busranurkocak/EE464-Term-Project/Presentation/Isolated_presentation.pptx

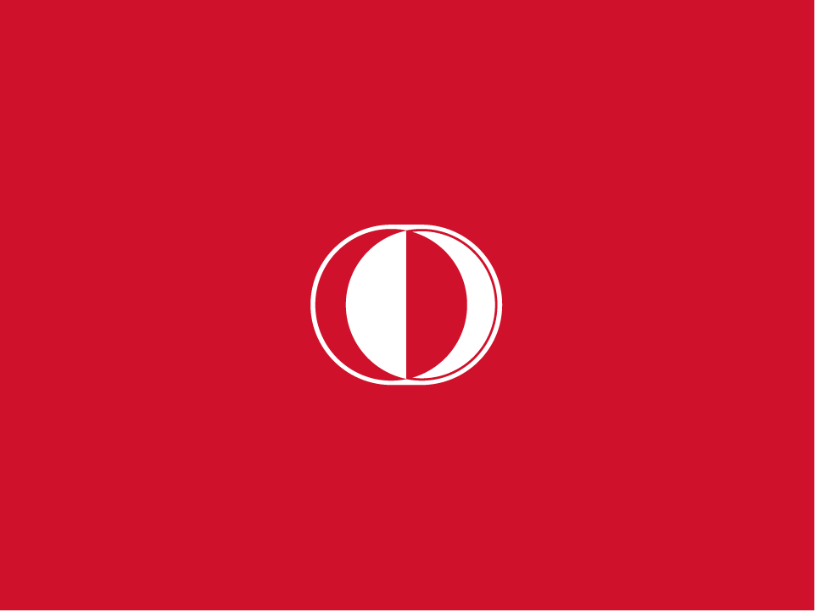
[picture p42: figure]

## Slide 2

EE464- TERM PROJECT

Büşra Nur Koçak
Defne Nur Korkmaz
Mustafa Mert Sarıkaya

May 9, 2021

## Slide 3

Topology selection
Component selection
Simulation results
PCB design
Magnetic design

## TOPOLOGY SELECTION

- FLYBACK CONVERTER


- Better utilization of transformer
- Easier to control
- DCM operation

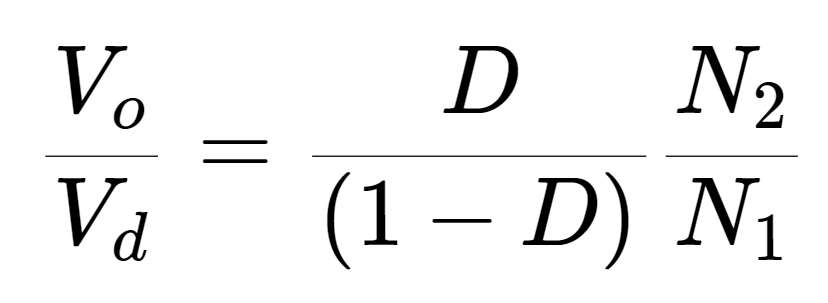
[picture p43: figure]

## Operating Values

- DCM operation:
- Limits flux density
  - Smaller core
- Reduce switching losses
- Smooth start

- D_(max) =0.2
- D_(dweel) =0.1
- f_s ≅100 kHz
- AWG #26 (skin effect)

## Magnetic Design

- K_g Method

- L_(pri) (80µH)
- Energy handling capability (1.2 mJ)
- K_g , core geometry (0.0148)
- Select core (EE-21)
- Current density
- Window area

- # of strands
- # of turns
- Air gap (0.0079 cm)
- Fringing flux
- New # of turns
- B_(pk) (0.39 T)

## Magnetic Design

- K_g Method cont’

- Winding resistance ( R_p =7.3mΩ, R_s =0.137mΩ )
- Copper loss (0.0360 W)
- K_u , window utilization
- Regulation

- Flux density
- Core loss (5.38 W)
- Temperature rise (61 ºC)

## Slide 8


## Slide 9

Turns ratio | L_(pri) | S_p (primary strands) | S_s (secondary strands) | K_u (window utilization)
6 | 80µH | 9 | 67 | 0.1

## Component Selection and Simulations

## Controller

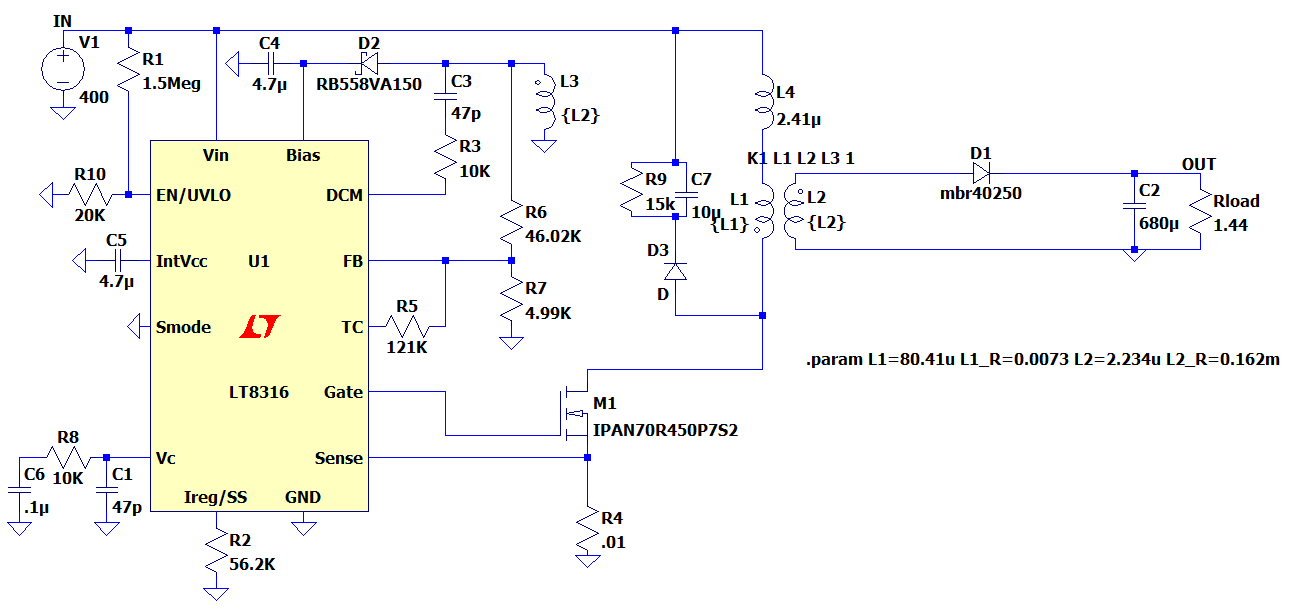
[picture p44: figure]

Parameter | Value - Description
Vin | 16V – 600V
FSW(Min) | 3 kHz
FSW(Max) | 140 kHz
Operating Junction Temperature | -40 – 125oC
Price | $2.18 (1000+ order)

## Mosfet (IPAN70R450P7S)

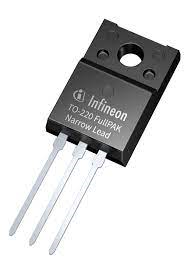
[picture p45: figure]

Parameter | Value - Description
VDS , Breakdown voltage | 700V
ID, Continuous current | 10A at TC =20 oC
ID,pulse Pulsed Drain current | 25.9 A
RDS,ON | 450mΩ
Qg | 13.1nC
Price | $1.05

## Mosfet Voltage Waveform

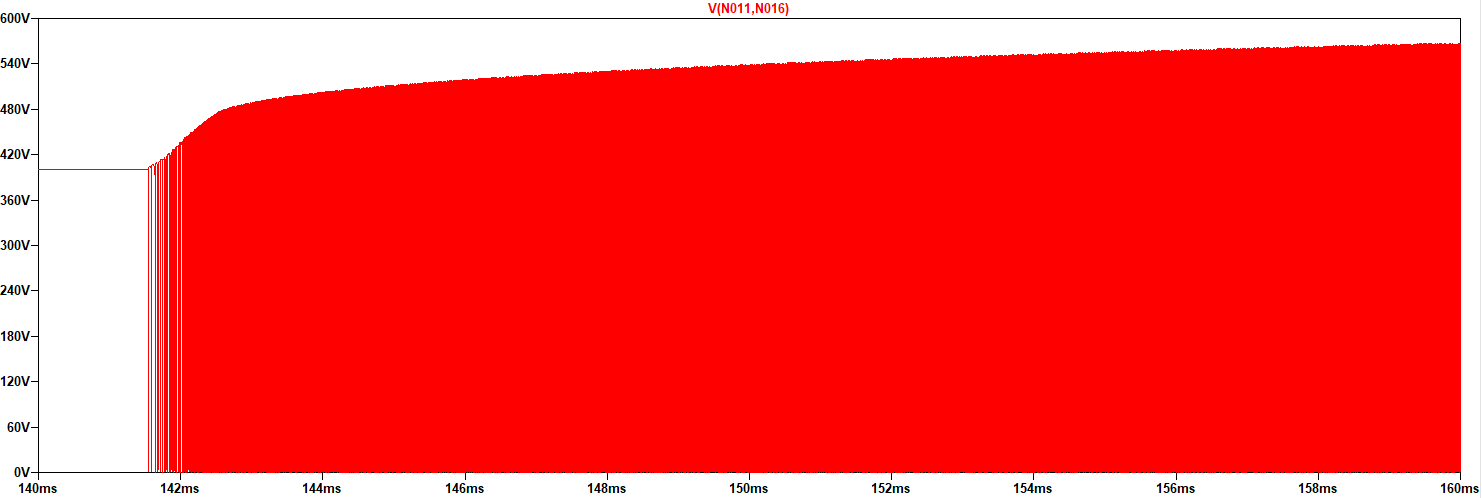
[picture p46: figure]
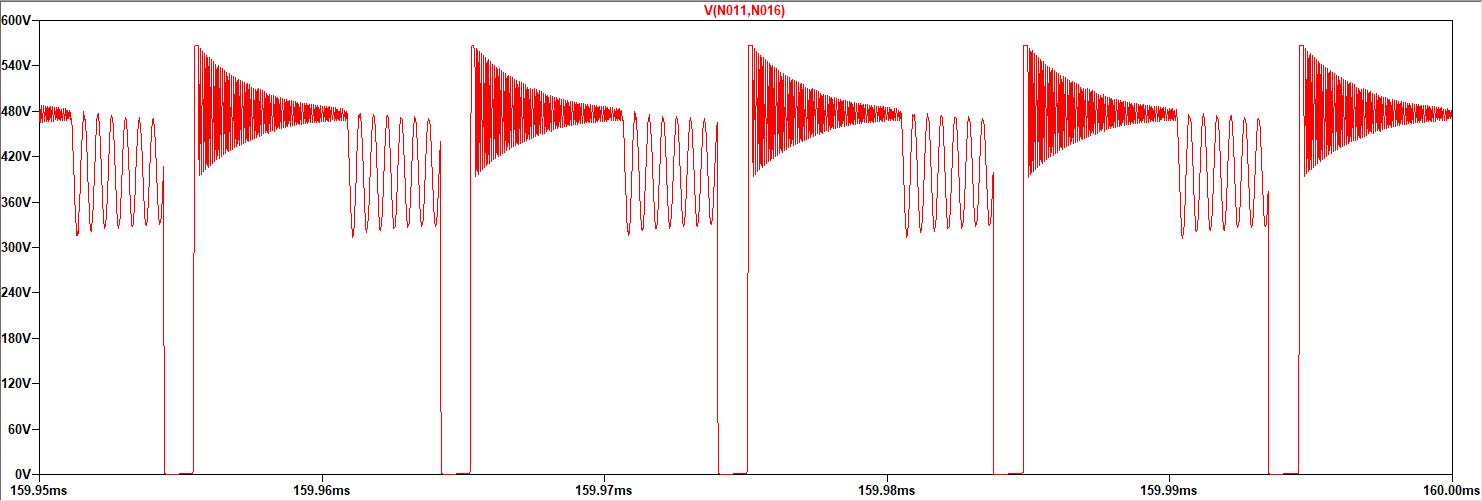
[picture p47: figure]

## Mosfet Current Waveform

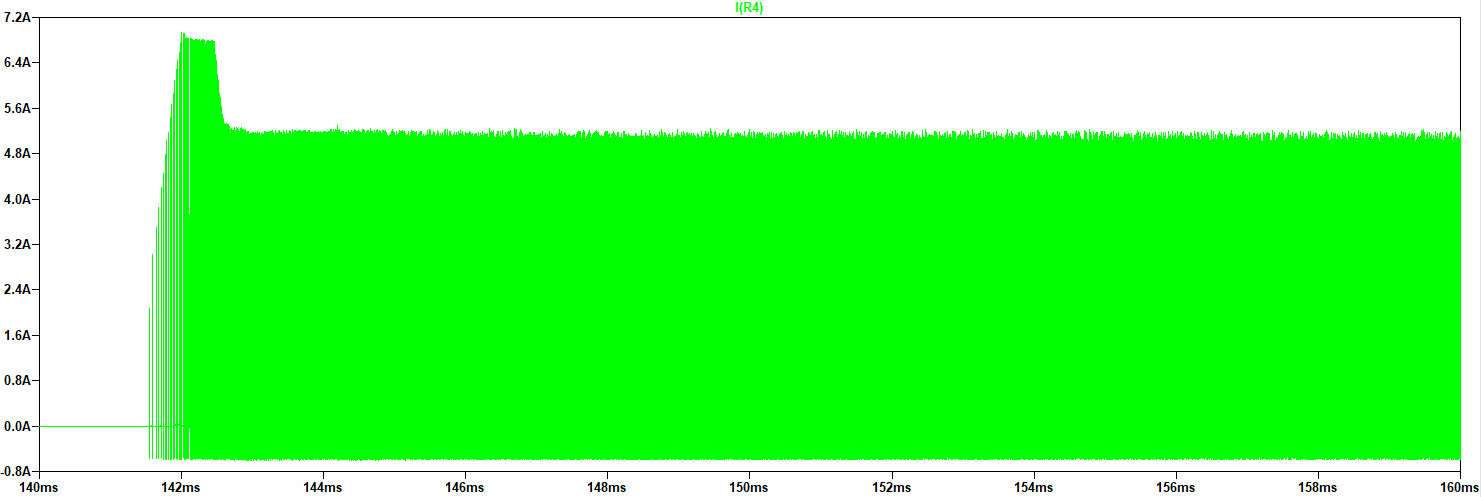
[picture p48: figure]
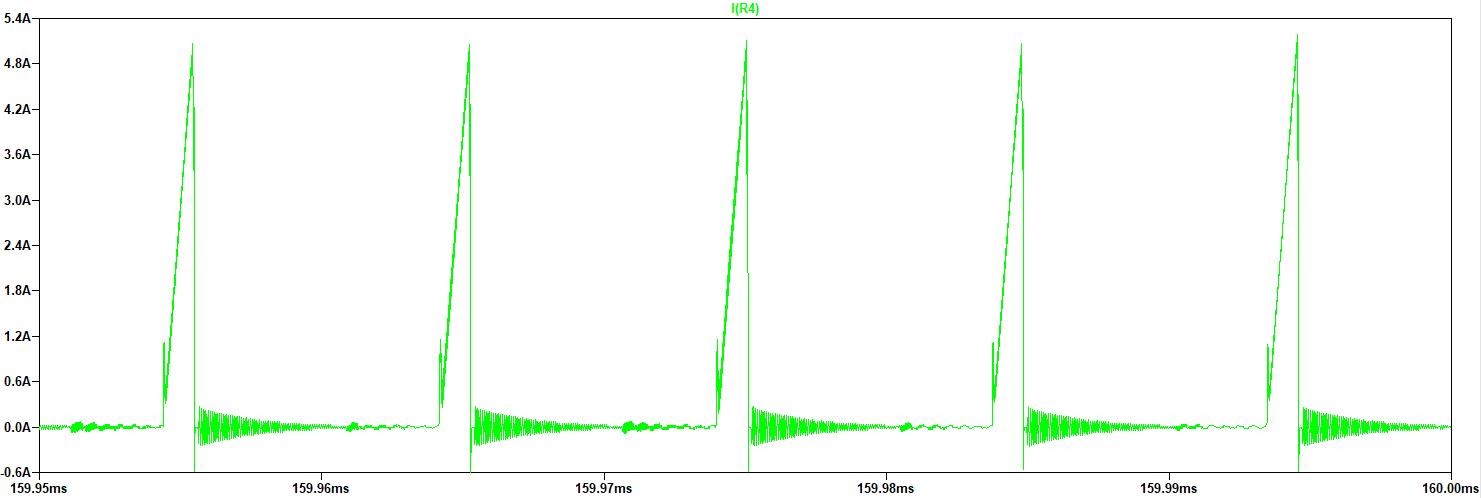
[picture p49: figure]

## Diode(MBR40250G)

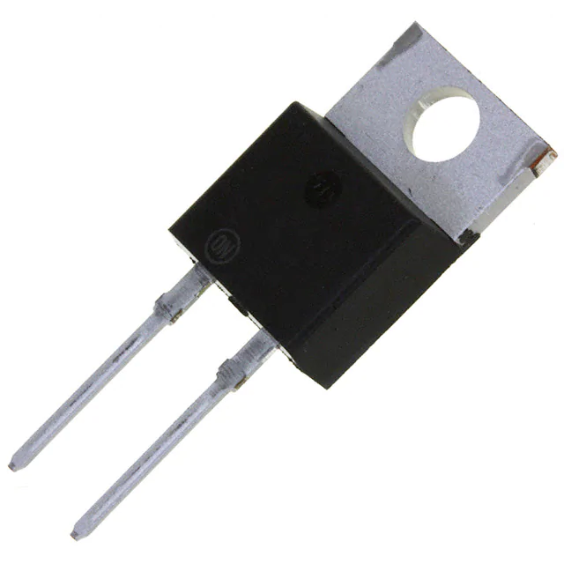
[picture p50: figure]

Parameter | Value - Description
VR , Blocking voltage | 250V
IRMS, Continuous current | 40A
IFRM, Peak Repetitive Forward Current | 80A
VF | 0.86V
Price | $1.82000

## Diode Voltage Waveform

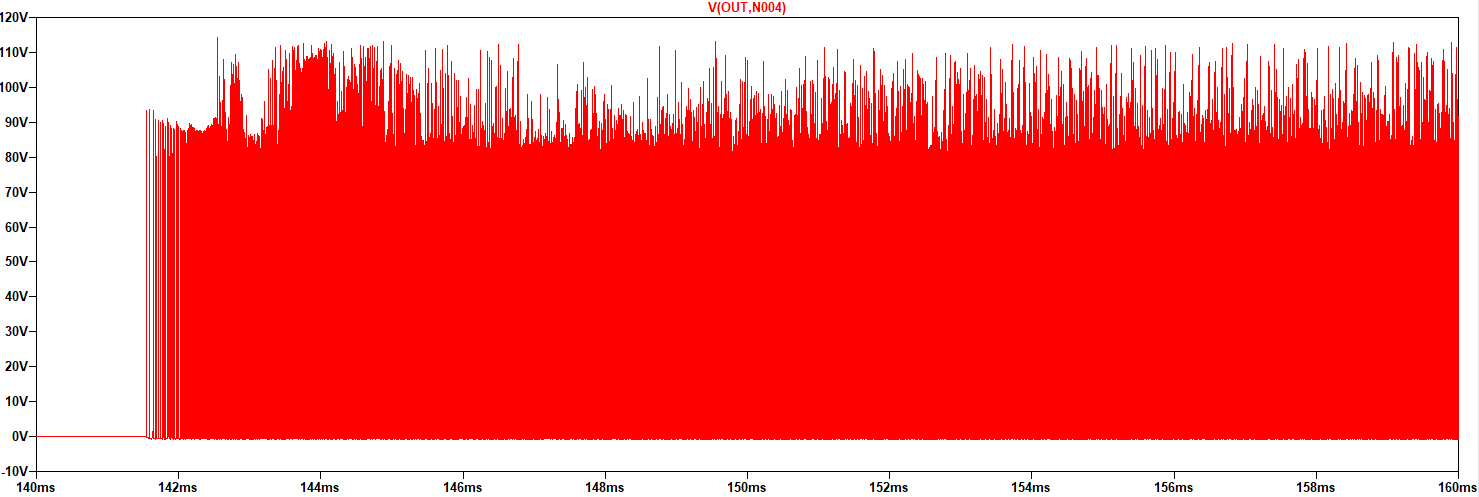
[picture p51: figure]
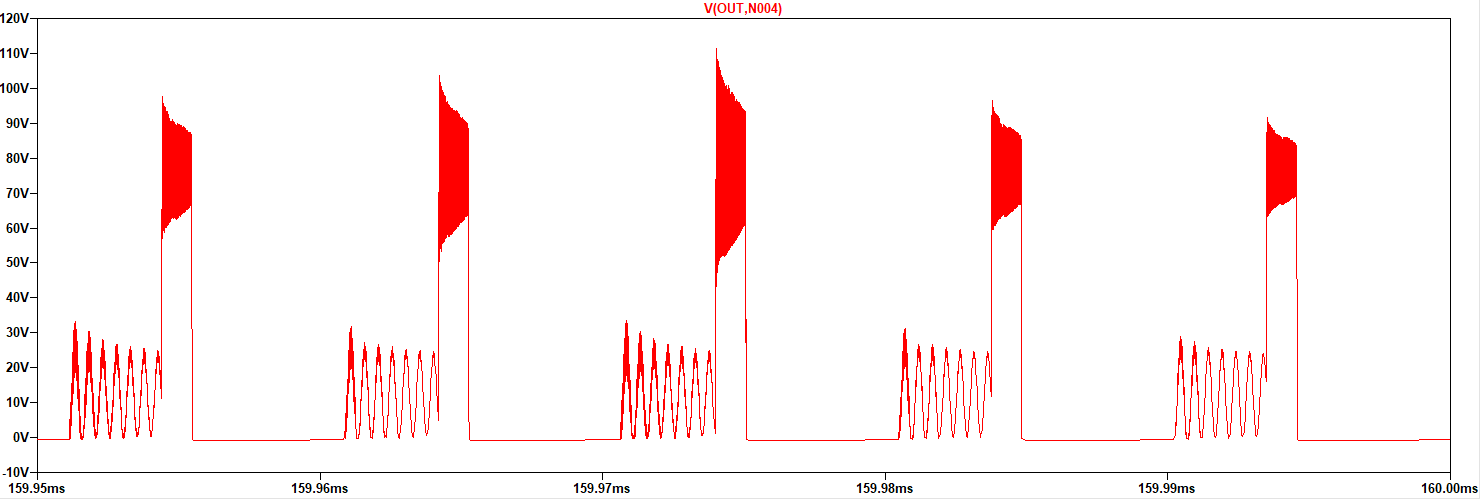
[picture p52: figure]

## Diode Current Waveform

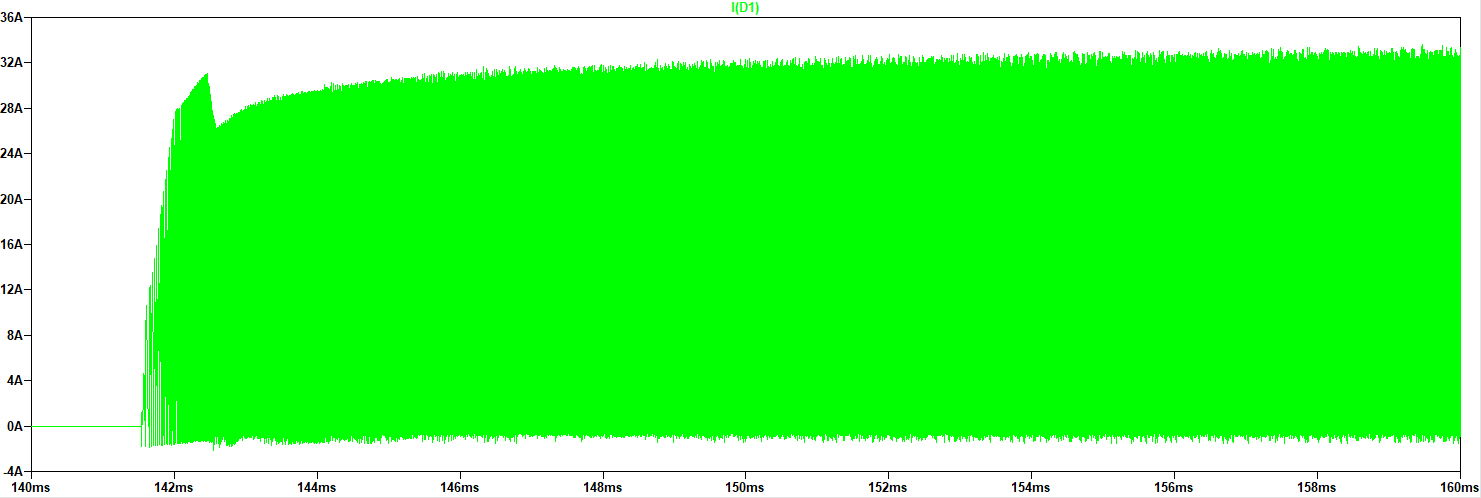
[picture p53: figure]
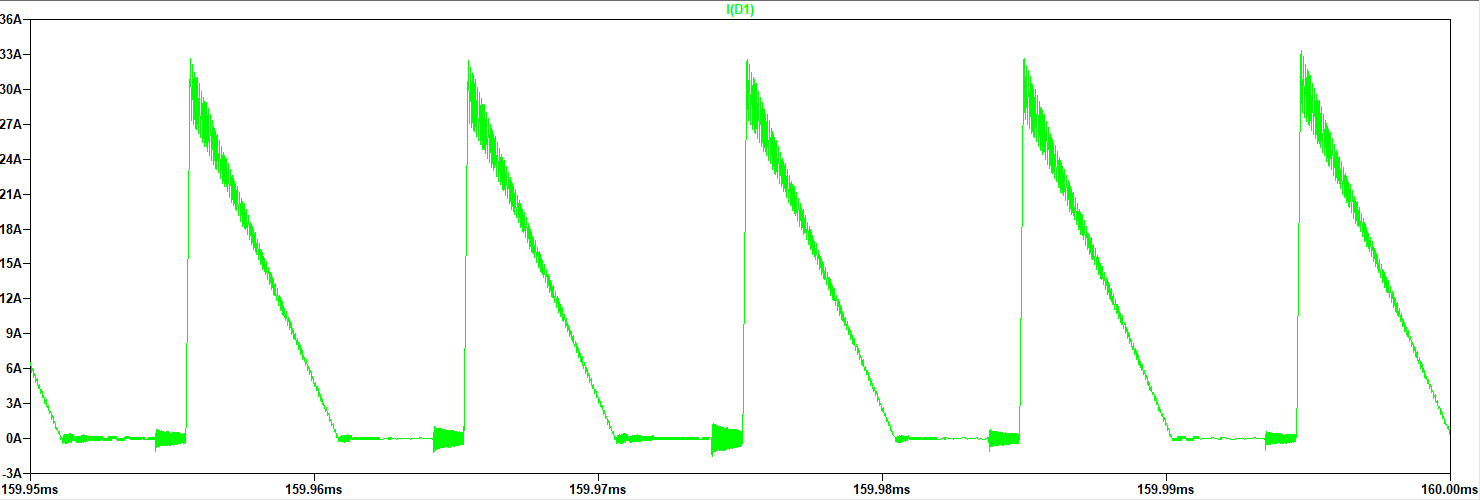
[picture p54: figure]

## Output Capacitor(RNL1C681MDS1)

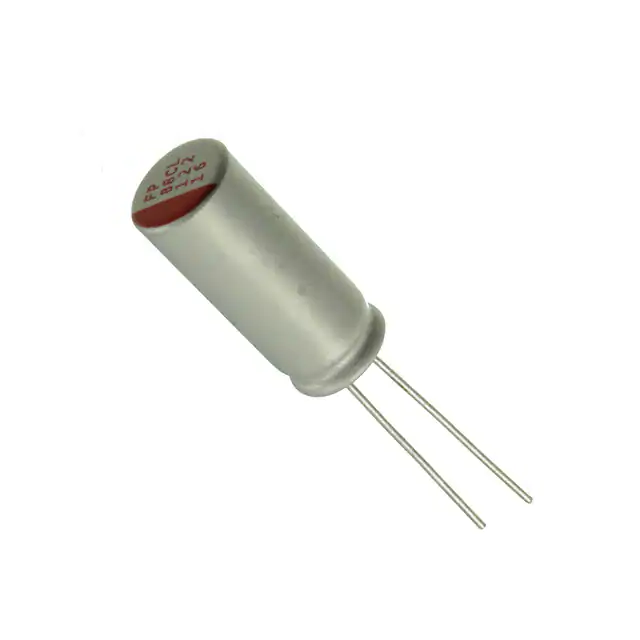
[picture p55: figure]

Parameter | Value - Description
C, Capacitance | 680 uF
VC,MAX Rating | 25V
IC,ripple | 7A
ESR | 8mΩ
Price | 1.50$

## Output Voltage Waveform

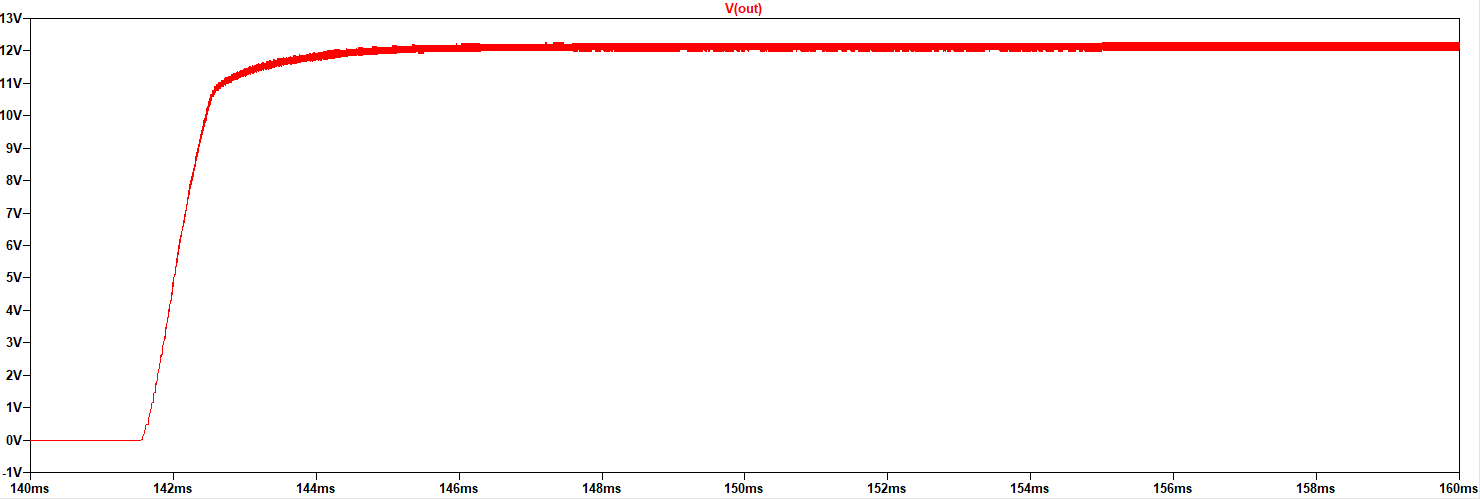
[picture p56: figure]
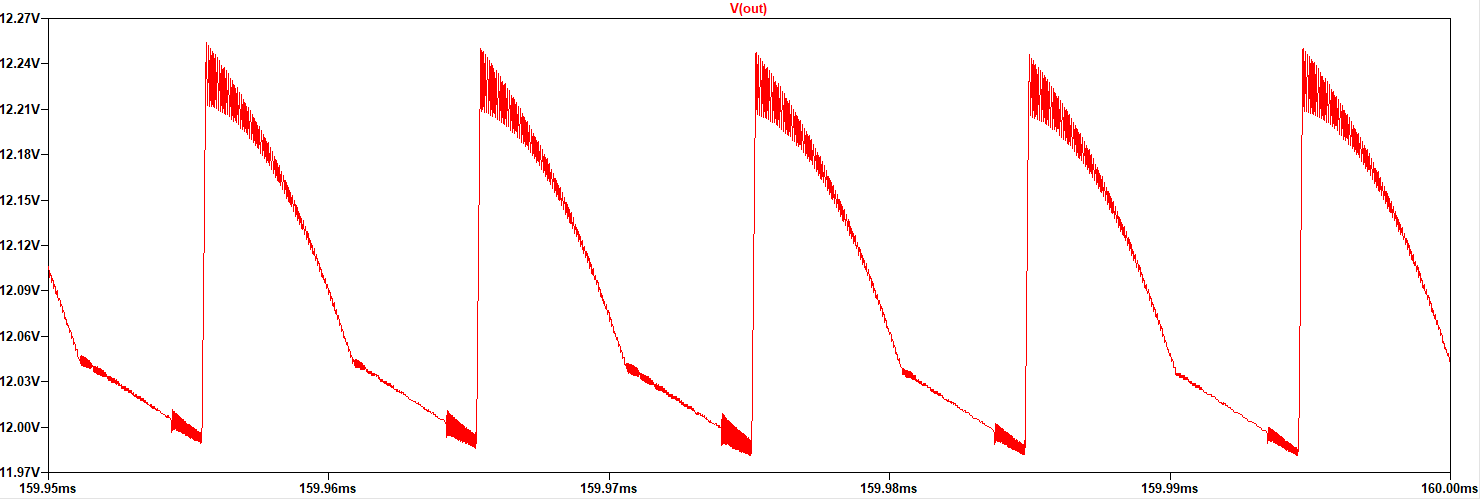
[picture p57: figure]

## Output Current Waveform

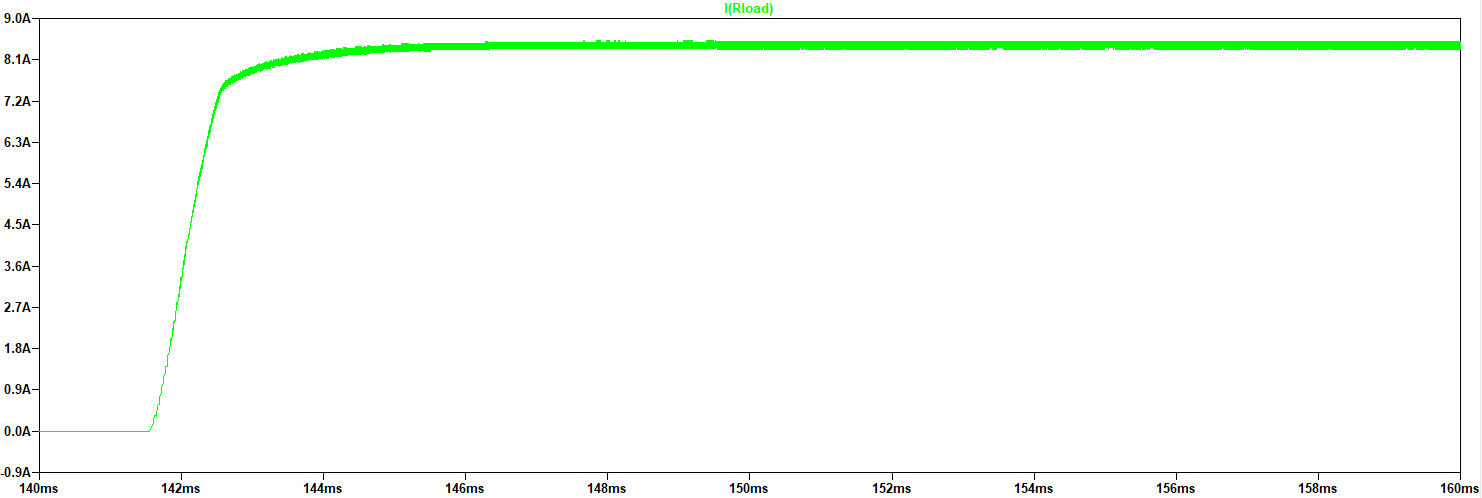
[picture p58: figure]
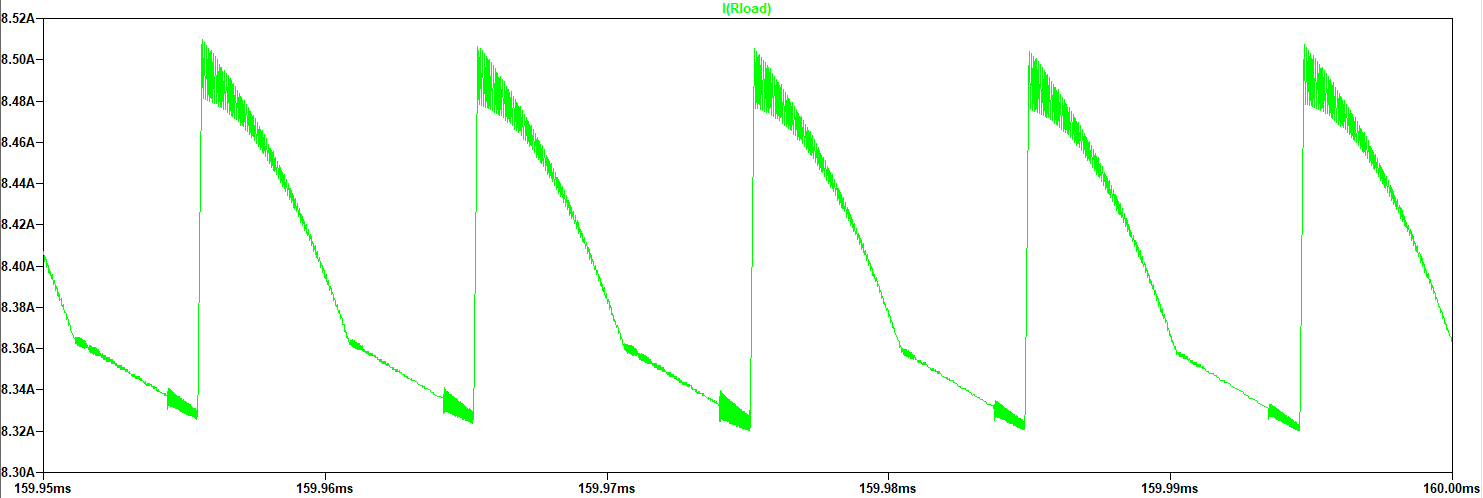
[picture p59: figure]

## Primary Inductor Current Waveform

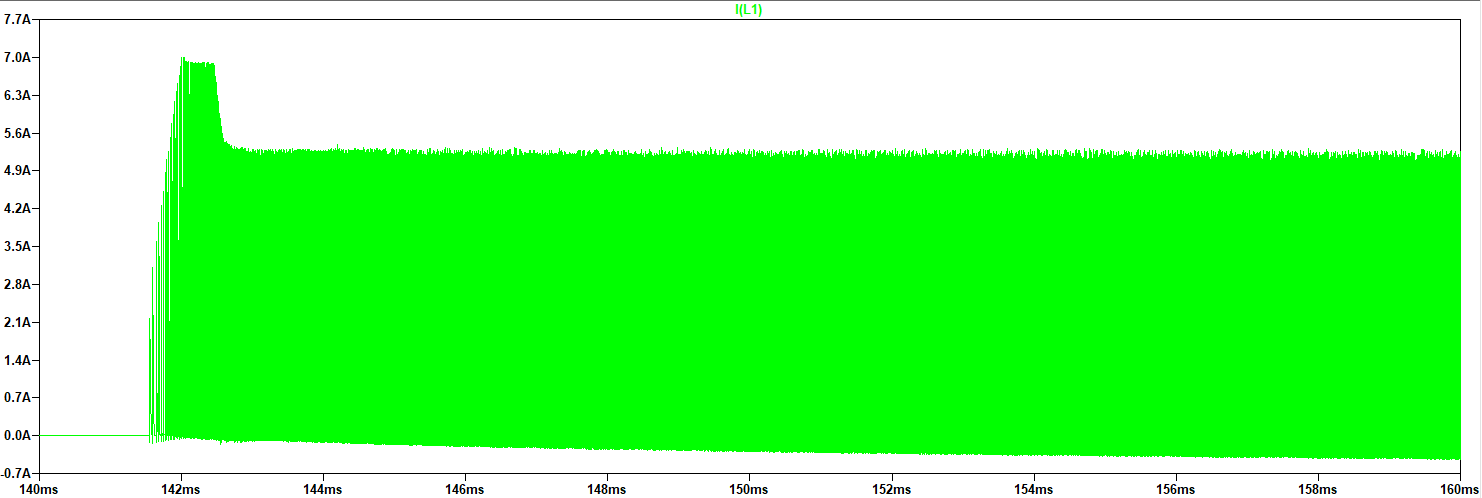
[picture p60: figure]
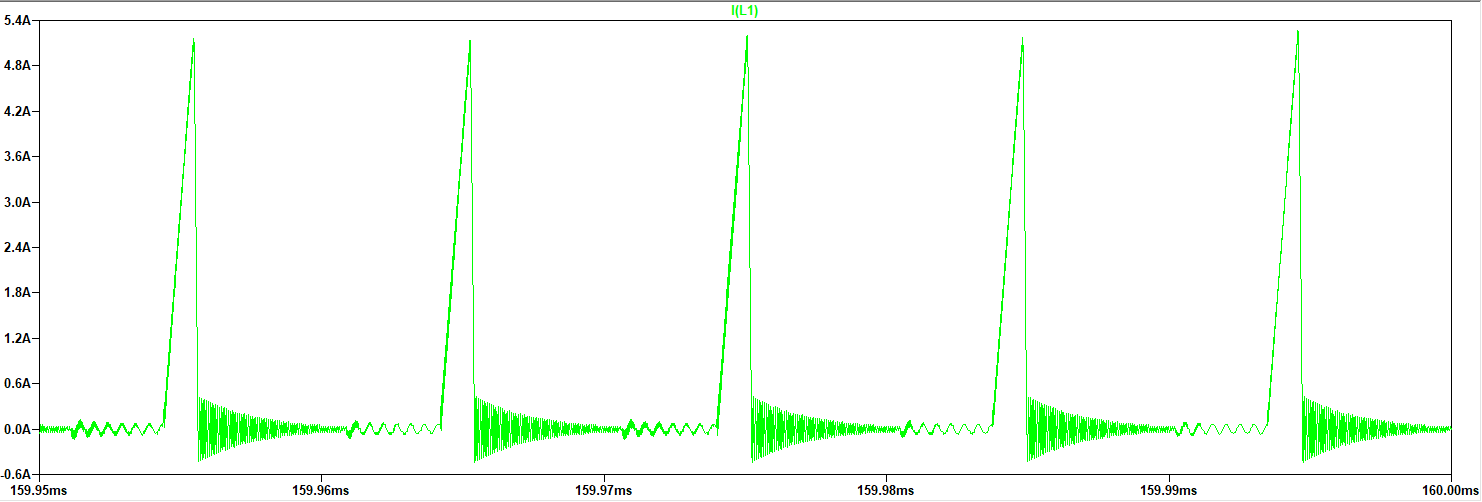
[picture p61: figure]

## Slide 22

## Slide 23
