busranurkocak/EE464-Term-Project/Simulation Report.pdf

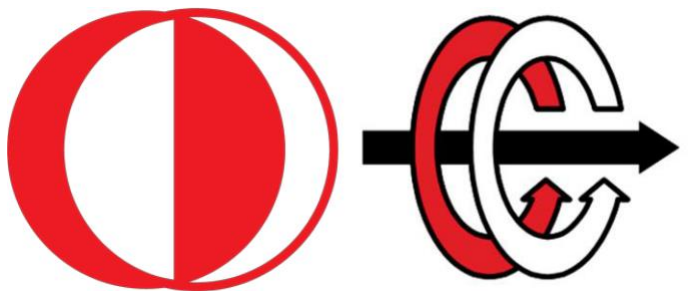
[picture p62: figure]

EE464

# STATIC POWER CONVERSION-II

## Term Project Simulation Report

## Group Isolated

Contributors
Büşra Nur KOÇAK | 1929355
Defne Nur KORKMAZ | 2166858
Mustafa Mert Sarıkaya | 2094381

## Table of Contents

## Introduction

The aim of this project is to provide the transformation that will convert the high voltage power supply output suitable for the low voltage range devices. Therefore, the study is about to reduce the input voltage ranging from 220V to 400V for the Tesla Model S’s equipment that needs 12V input voltage. Since one of the most important requirements of the project was to provide an isolated system design, the topology types used in the given operating ranges, which will allow isolated converter design, were examined. Afterwards, the controller was selected according to the selected topology and the frequency range, duty cycle and turns ratio values to be operated were determined. With the completion of the transformer design and component selections in accordance with the simulation results taken from the selected controller, the theoretical calculations and the power loss calculations of the system have been completed.

## Project Description

In this project, we are asked to design an isolated DC/DC converter in order to convert 220-400VDC input voltage to 12VDC with 100W output power. The specifications and requirement for the projects are following:

- Minimum Input Voltage: 220 V
- Maximum Input Voltage: 400 V
- Output Voltage: 12 V
- Output Power: 100 W
- Output Voltage Peak-to-Peak Ripple: 4%
- Line Regulation: 3%
- Load Regulation: 3%

## Topology Selection

### Forward Converter

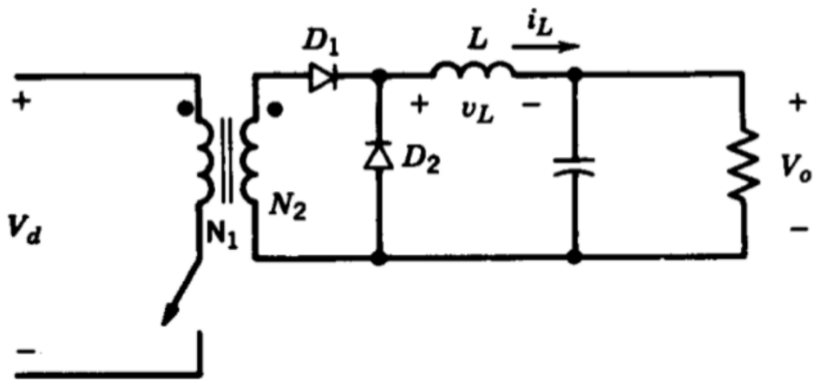
[picture p63: figure]

Figure 1: Forward Converter Topology

Advantages:

- Allows smaller transformer design than a flyback converter
- Better at isolated high-power applications
- Switching device has less voltage stress across it
- Low power losses and noise
- Does not require any snubber circuit

Disadvantages:

- The transformer core must be freed from unintentionally stored energy with each cycle
- Requires additional inductor at the output side
- More expensive
- Harder to control

### Flyback Converter


Figure 2: Flyback Converter Topology

Advantages:

- Better utilization of transformer
- Output inductor and diode ensure continuous output current
- More efficient to filter out high-frequency components
- Easier to control
- DCM operation allows soft switching
- Allows to use smaller transformer core
- Reduce switching losses

Disadvantages:

- Higher voltage stress across the MOSFET
- Gain changes a lot in DCM operation

Forward and Flyback converter topologies have been considered and examined in detailed while deciding on the topology which will be used in the project. According to the advantages and disadvantages of the both topologies, it has been decided to work on the Flyback converter design. While making the topology selection, some of the important factors have been evaluated as providing easier control of the converter and finding isolated controller options that meets the project requirements. In addition to these, the difficulty of controlling the forward converter and the possibility of causing problems in cases where the energy on the transformer could not be discharged regularly, made it certain to prefer the flyback converter topology.

## Analytical Calculations

### Transformer Calculations

In an isolated flyback converter design, the core selection completely depends on the operating frequencies. As the operating frequency increases, maximum flux density created will decrease; therefore, increasing operating frequency is an advantage to prevent saturation in the core and also helps to use smaller core structure with increased efficiency. Smaller transformer core also helps to decrease the cost and size of the converter with a considerable amount. Therefore, the calculations of the transformer have been conducted considering 100kHz operating frequency, even though it will be adjusted by the flyback controller itself.

Moreover, operating region is also an important factor while deciding the size of the transformer core, where DCM operation allows to design smaller transformers by limiting flux density in the core and prevents from the saturation problems. Therefore, DCM operation has been assumed to be used in the design while calculating transformer values and dwell time duty ratio (Dw) is assumed to be 0.1.

In the first transformer design of the process, ferrite cores with an additional gap will be considered using Kg method, which allows to calculate required air gap, fringing losses and the cable losses in the transformer design. Moreover, this method allows to count the required strands number for the Litz wire design according to the selected core properties.

### Skin Effect

Operating frequency of the transformer is a primary property while deciding the cable size, which will be used during the design. Increasing operating frequency will cause current to flow from more outer part of the cable. Therefore, the middle part of the cable will be useless in the conduction period and this will cause increase in the resistance values. Considering this relationship between the frequency and cable size, it is preferred to design the transformer cables as Litz wire with multiple strands by calculating the number of layers which should be used for primary and secondary sides. Considering this perspective, calculating the skin depth for 100kHz gave an important clue while deciding the size of the cable which will be layered.

ε =

6.62
√f

=

6.62
√100 × 10³

= 0.0209 → Wire Diameter = 2ε

= 0.0418

[1]

According to the calculation done in the [1], it had been decided to use #26 AWG wire as base wire while designing the Litz wire size and number of layer requirements.

### Ferrite Core Calculations

The first specification which should be considered while designing the transformer for flyback converter is that the energy storage capability of the core. Therefore, the inductance needed for the storage of a specific amount of energy storage is also important.

Rin(eqiv) =

(Vin(min))

2

Pin(max)

→ L =

Rin(equiv)TDmax

2
2

→ Energy

=

LIp(pk)

2
2

[2]

As the name suggest Kg value, which is a core geometry values includes both energy requirements of the transformer application. Therefore, this value has been calculated first to decide the limiting value for the power handling capacities of the core selection.

Ke = 0.145PoBm

2 × 10⁻⁴ → Kg =

(Energy)

2
Ke ∝

[cm⁵
]

[3]

Considering both the Kg value, saturation conditions of the ferrite cores, window area, permeability and inductance value per N

2
, EE-21 core have been chosen to be the core of the transformer design to continue with the calculations.

Table 1. Design data for EE ferrite cores

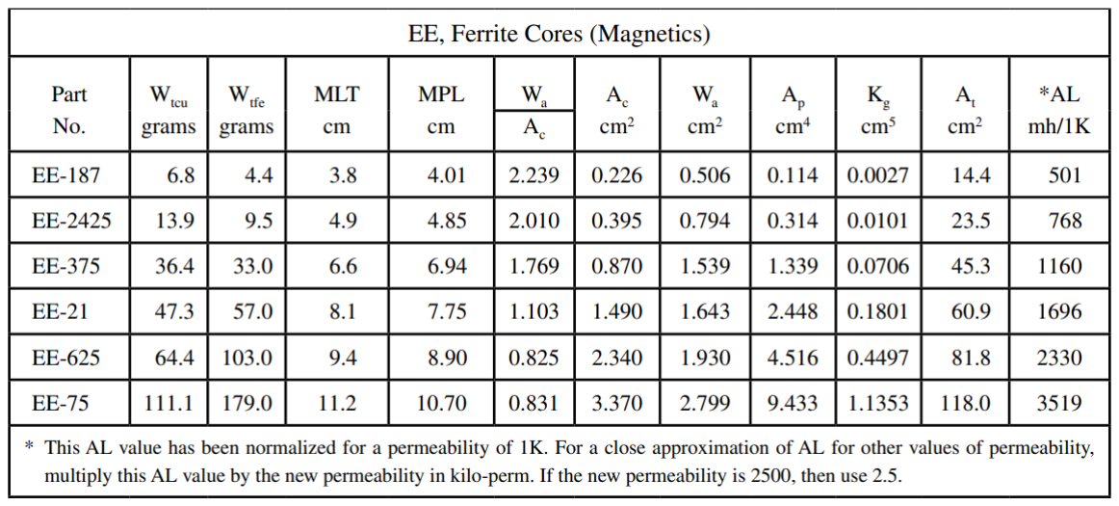
[picture p64: figure]

Before getting into the core calculations, the peak and rms values of the primary current have been calculated for the future calculations considering both current density in the core and strands numbers required for the transformer design.

Ip(pk) =

2Po(max)T

ηVin(min)

ton(max)

[amps peak], Ip(rms)

= Ip(pk)√
ton
3T

[amps]

[4]

Moreover, the values of the selected core structure have been used to calculate the current density, wire area in the core, required number of strands and number of turns with the Equations [5], [6], [7], [8].

J =

2(Energy) × 10⁴
BmApKu

[A/cm²
]

[5]

Bm: Maximum flux density, [T]

Ap: Area Product, [cm⁴
]

Ku: Window utilization, 0.29

Apw =

Ip(rms)
J

[6]

Apw: Primary wire area

Snp =

Awp
#26(bare area)

[7]

Snp: Required number of primary strands

Np =

Ku Wa⁄2
3(#26(bare area))

[turns]

[8]

Wa: Window area of the core

Np: Number of primary turns

Because of the high permeability values of the ferrite cores, storing the required energy in the core requires some additional gap. Calculation of the additional gap for storing previously specified energy value can be observed from Equation [9].

lg =

0.4πN

2Ac × 10⁻⁸
L

−

MPL
μ

[cm]

[9]

Ac
: Iron area

MPL: Magnetic path length

μ: Permeability of the core material

It should be also considered that even though adding a gap to increase the energy storage capability of the ferrite core is a preferred method at some cases, it has some disadvantages as fringing flux. Therefore, this effect should be also calculated to consider its effect on the power loss of the transformer design.

F = 1 +

lg
√Ac

ln (

2G
lg

)

[10]

Moreover, the fringing flux also has an effect on the number of required turns in the primary side of the transformer and the peak flux density as follows.

Nnp = √
lgL
0.4πAcF10⁻⁸

[11]

Nnp: New number of turns for the primary

Bpk =

0.4πNnpFIp(pk)10⁻⁴

lg +

MPL
μ

[T]

[12]

MPL: Magnetic path length

As the number of turn and strands values of the primary have been completed, ESR resistance of this side can be also determined by considering both the designed Litz wire strands, #26 AWG copper wire resistance property, number of turns in the primary and the magnetic path length of the selected core.

Rp = MLT(Nnp) (
μΩ⁄cm

Snp ) × 10⁻⁶
[Ω]

[13]

Moreover, secondary side of the transformer can be calculated with the values, which have been calculated so far. Decided duty cycle and dwell time duty ratio plays an important role while calculating the secondary side of the transformer. Moreover, the voltage drop on the output part of the flyback converter is assumed to be 1V during the calculations.

Ns =

Nnp(Vo + Vd)(1 − Dmax − Dw)

VpDmax

[14]

Other than the turn number of the secondary of the transformer, same calculations have been applied to calculate secondary peak current, rms current, wire area, secondary strands number, and winding resistance.

Turns ratio | Lm(mutual inductance) | Sp(primary strands) | Ss (secondary strands) | Ku(window utilization)
6 | 80µH | 9 | 67 | 0.1

### Component Power Calculations

Specifications of project are

Vin(min) =220 V,

Vin(max) =400V,

Pout =100W,

Vout=12V

We have to decide some values for calculation and to get smaller transformer and ripples we decide switch frequency as 100khz. Our system will operate in Discontinuous conduction mode and we decide dwell time as one over ten period time. Also, maximum duty ratio as taken 0.2. Our secondary side diode will operate at high current so we can’t just assume its on voltage as zero volt, before deciding diode we take diode on voltage as 1V. Transformer won’t operate at 100% efficiency and before designing that we assume efficiency as 90%. So decided values are as given.

fS = 100kHz

Ddwell = 0.1

Dmax= 0.2 at 220V and Dmin = 0.11 at 400V

Vdiode = 1 V

ɳtransformer = 0.9

Primary and Secondary powers

By using output power and output voltage, average output current calculated. Then diodes power dissipation added and secondary sides total power calculated. Transformer is not ideal and we choose efficiency as 90% percent and primary sides power calculated with including core loss.

Iout(avg)= Pout / Vout = 8.33 A

Pdiode = Vdiode x Iout(avg) = 8.33 W

Psecondary = Pdiode + Pout = 108.33 W

Pprimary = Psecondary / ɳtransformer = 120.37 W

Primary and secondary sides peak current:

Primary and secondary sides inductor current is triangular shape and its peak value calculated with the following equations.

For 220 volt source voltage:

Iin(avg) = Pprimary / Vin(min) = 0.55 A

Iin(peak) = 2 x ( Iin(avg) / Dmax) = 5.47 A

For 400 volt source voltage:

Iin(avg) = Pprimary / Vin(max) = 0.55 A = 0.30 A

Iin(peak) = 2 x ( Iin(avg) / Dmin) = 5.47 A

Isecondary(peak) = 2 x (Iout(avg) / (1 - Dmax - Ddwell)) = 23. 80 A

Ratings of Components

Transformer, Mosfet, Diode and Output Capacitor are important components for flyback converter, Transformer’s calculation showed in previous part and turn ratio taken as 6. Mosfet, Diode and Output Capacitors required ratings analytically calculated in following equations.

Nturn = 6

For Mosfet:

VDS(max) = Vin(max) + (Vout x Nturn) = 472 V

IDS(peak) = Iin(peak) = 5.47 A

For Diode:

VD(max) = Vout(max) + (Vin(max) / Nturn) = 78.67 V

ID(max) = Isecondary(peak) = 23.80 A

Output Capacitor:

∆Vout(max) = Vout x (3/100) = 0.36 V

IC(pp) =(Iout(avg) x (1+ ((Dmax + Ddwell) / (1 - Dmax - Ddwell))) = 11.90 A

∆VESR = ESR x IC(pp) = ESR x 11.90

∆QC = Iout(avg) x (Dmax + Ddwell) / (Cout x fS) = 2.5x10⁻⁵ C

∆VC = ∆QC / Cout = 2.5x10⁻⁵
/ Cout

∆Vout = ∆VESR + ∆VC = ESR x 11.90 + 2.5x10⁻⁵
/ Cout

When Cout is infinity ESR must be smaller than 30.25 mΩ

When ESR is zero Cout must be bigger than 69.44 uF

## Component Selection

In the previous part, we have decided the required component values with the LTSpice simulation tool and calculations. To provide a reliable design, we considered the inrush currents and surge voltages. Therefore, we have chosen our components by considering the maximum power rating and its tolerance. Also, in order to decrease the final size of the design, we tried to choose the component in small packages.

At first, we have decided on the controller. We have needed a flyback controller which provides 100W power and around 100kHz frequency range to decrease the size of the transformer. Also, to make the simulation part easier, we looked for the Analog Design Manufacturer. In the end we have decided on the LT8316 controller.

Then, we looked for the semiconductor components which are MOSFET as a switch, diodes for the secondary side of the converter and for biasing of the controller. As a mosfet, we have decided on IPAN70R450P7S. Its ratings are given in Table 2.

Table 2. Mosfet Ratings

Parameter | Value - Description
VDS , Breakdown voltage | 700V
ID, Continuous current | 10A at TC =20 oC
ID,pulse Pulsed Drain current | 25.9 A
RDS,ON | 450mΩ
Qg | 13.1nC
Price | $1.05

Then, the diode of the secondary side is chosen as MBR40250G which provides 40A continuous current and 80A repetitive current.

Table 3. Diode Ratings

Parameter | Value - Description
VR , Blocking voltage | 250V
IRMS, Continuous current | 40A
IFRM, Peak Repetitive Forward Current | 80A
VF | 0.86V
Price | $1.82000

The biasing diode is chosen as to provide 5A continuous and 8A surge current. Also, it needs a small forward voltage. For this purpose, we have decided on BAS3010A03WE6327HTSA1 diode.

Then, we have worked on the capacitors and resistors in the circuit. The most important capacitor is output capacitor and the most important resistor is sense resistor. The output capacitor is chosen as it represents low ESR value and appropriate capacitance and voltage rating. Therefore, it is chosen as RNL1C681MDS1.

Table 4. Output Capacitor Ratings

Parameter | Value - Description
C, Capacitance | 680uF
VC,MAX Rating | 25V
IC,ripple | 7A
ESR | 8mΩ
Price | 1.50$ - (QTY:1)

The sense resistor should be in small resistance value and should handle the power that will flow through it. Therefore, it is chosen as WK73S2ATTDR10J which is 100mΩ and 1W power rating resistor.

The other capacitors and resistors are chosen according to their voltage value on the simulation. The important thing is here, they are chosen the smallest package in the required ranges.

## Simulations

After components selected their model implemented in LTspice and simulations test applied under given condition.

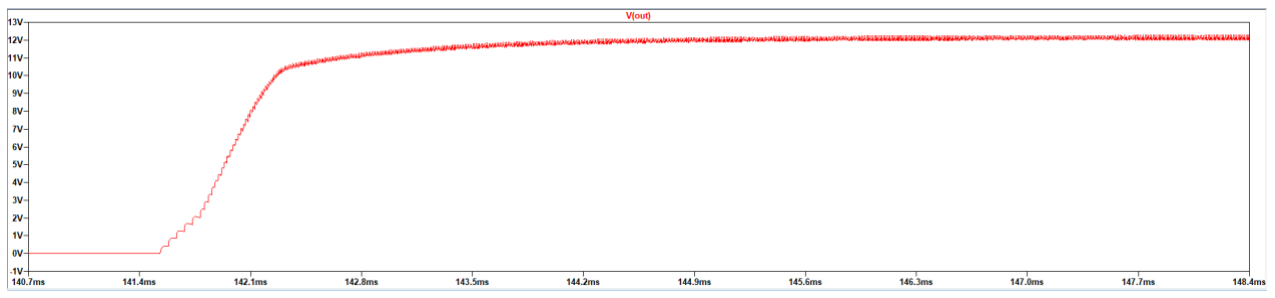
[picture p65: figure]

Figure 3: Output voltage waveform

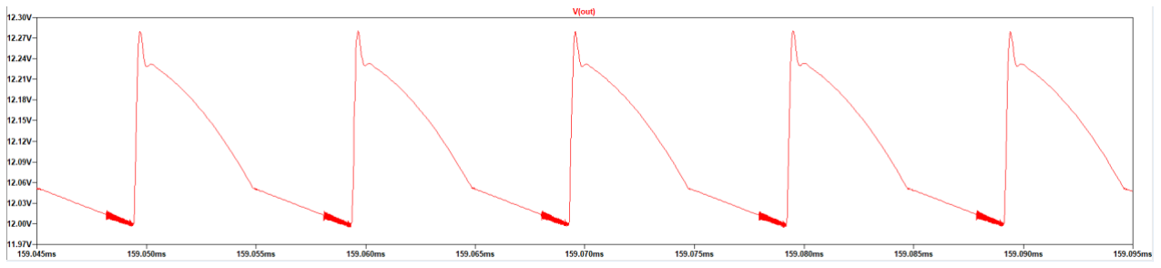
[picture p66: figure]

Figure 4: Output voltage close view waveform

As seen in the figure 3 after system turn on output voltage increase to the 12 V and give stable output voltage. Figure 4 shows ripple of output voltage and it is 0.28 V so output voltage ripple ratio is 2.33% and it is appropriate for project requirements.

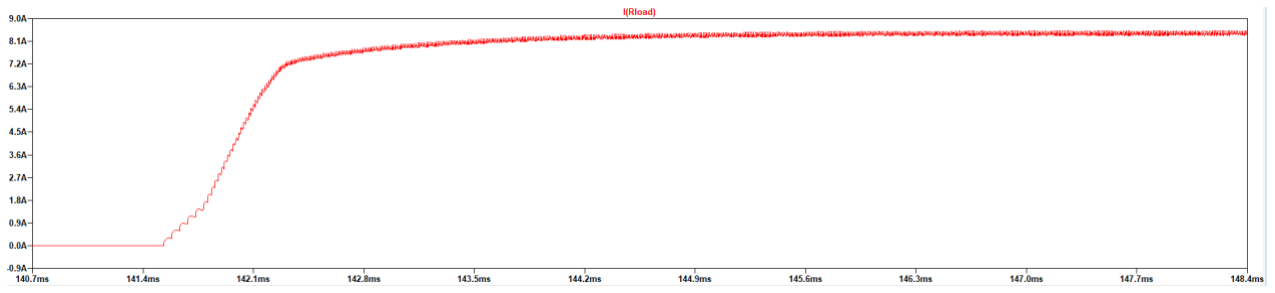
[picture p67: figure]

Figure 5: Output current waveform

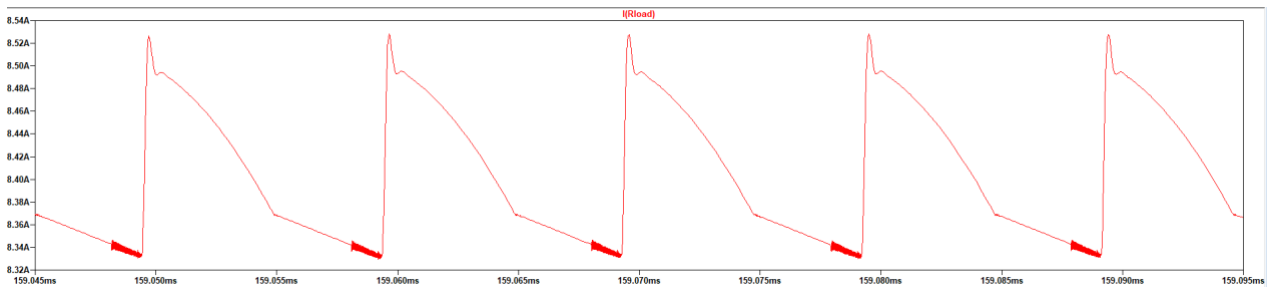
[picture p68: figure]

Figure 6: Output current close view waveform

In simulation tested load taken as fully resistive component and it is 1.44Ω so output current waveforms same as voltage and output power 101.15 W and it is little exceeding our rated power.

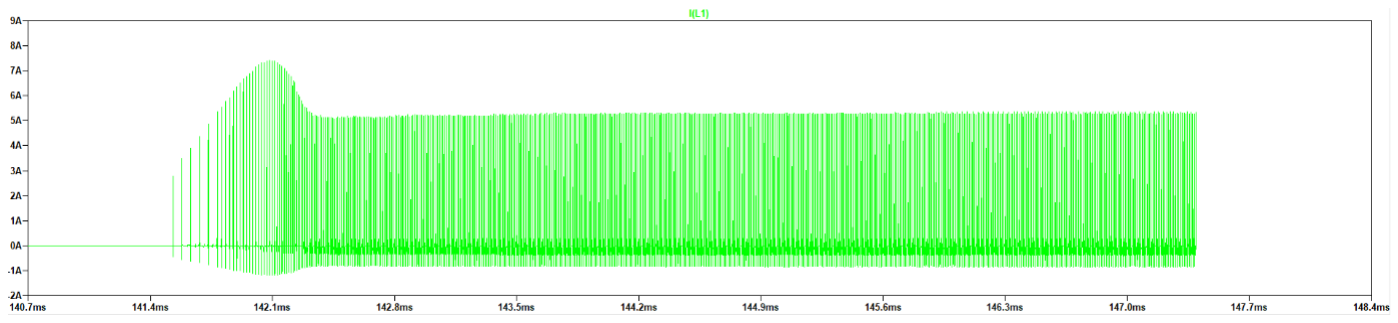
[picture p69: figure]

Figure 7: Primary inductor current waveform

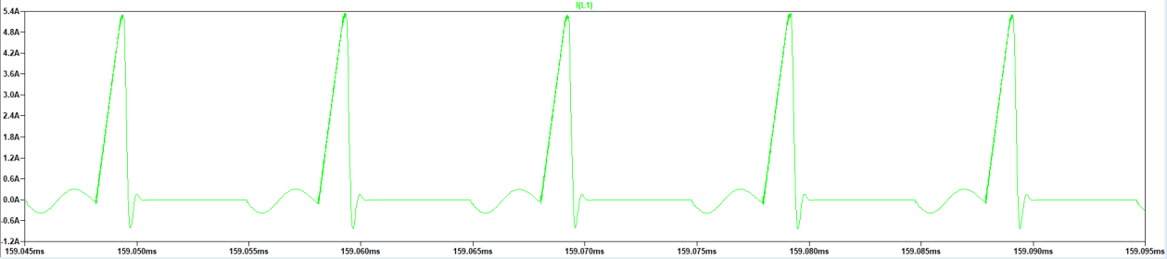
[picture p70: figure]

Figure 8: Primary inductor current close view waveform

When we look at the figure 7 its seen that initially current increase up to 7.5A then it is settled at 5.2A because initially output voltage is zero and system have to charge output capacitance and feedback system of the controller increase duty cycle and this result higher primary current. At figure 8 triangular shape of inductor current seen at mosfet on.

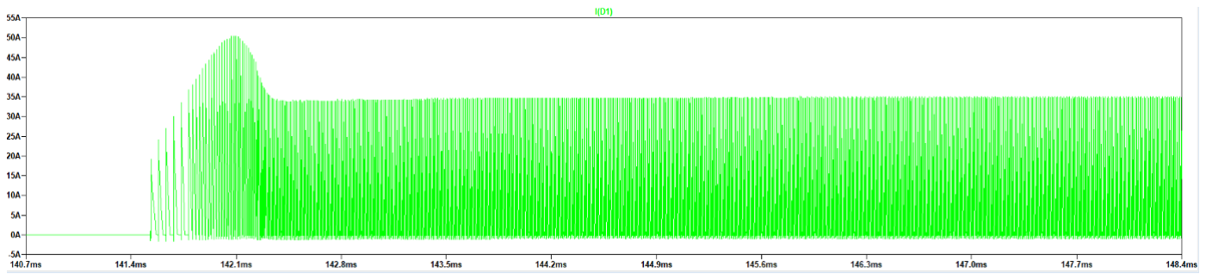
[picture p71: figure]

Figure 9: Secondary inductor current waveform

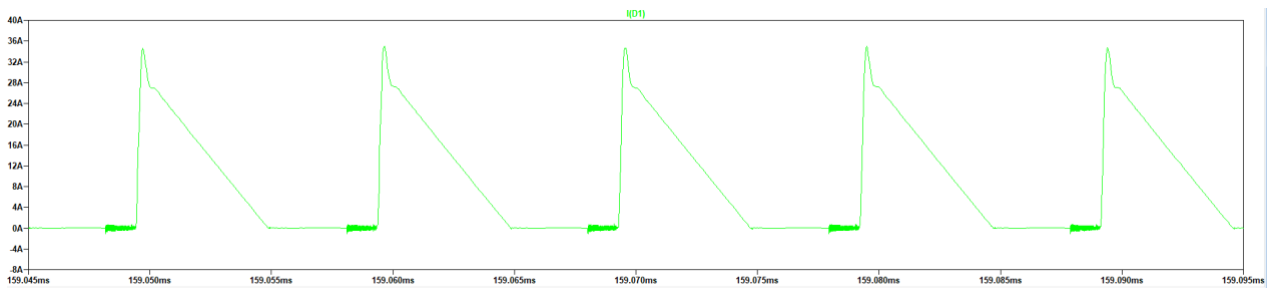
[picture p72: figure]

Figure 10: Secondary inductor current close view waveform

Secondary part of transformer has higher current density and its pulsative current reach 50 A at initial time then it is fixed at 35A.

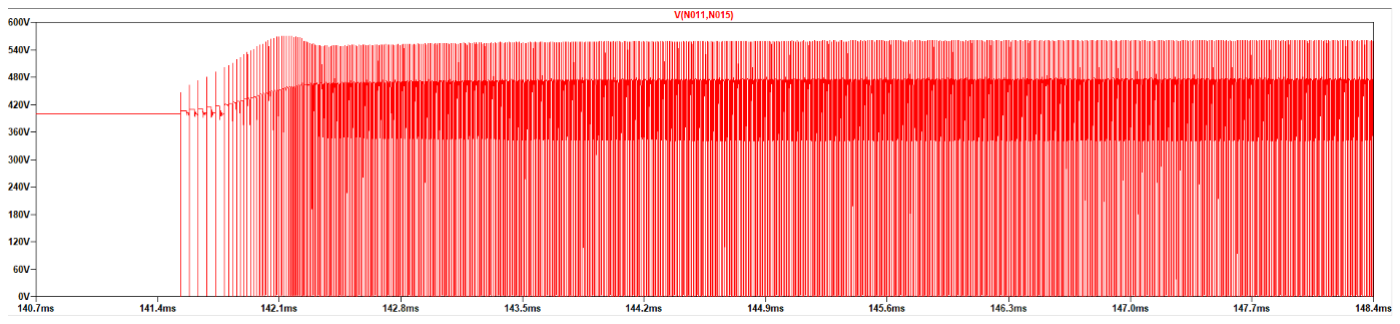
[picture p73: figure]

Figure 11: Mosfet voltage waveform

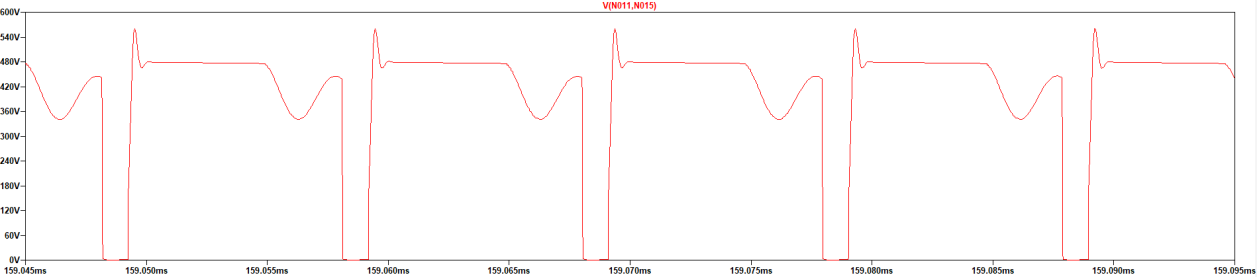
[picture p74: figure]

Figure 12: Mosfet voltage close view waveform

Selected mosfets breakdown voltage is 700 V and as seen in the figure 12 its voltage jumps to the 560V when it is turn of because of the leakage inductance then it decrease to the 478V. At Ddwell time its voltage oscillates. When looked at the figure 9 and 11 they’re in the our mosfets operation region.

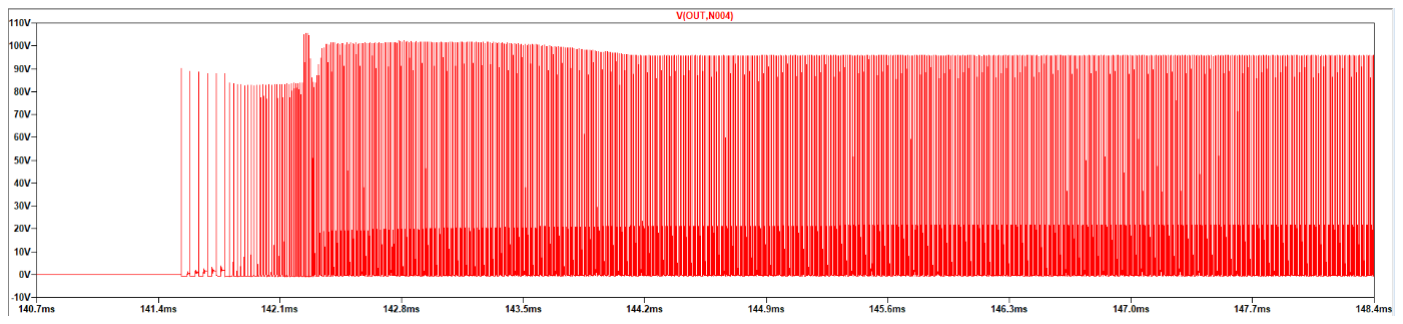
[picture p75: figure]

Figure 13: Diode voltage waveform

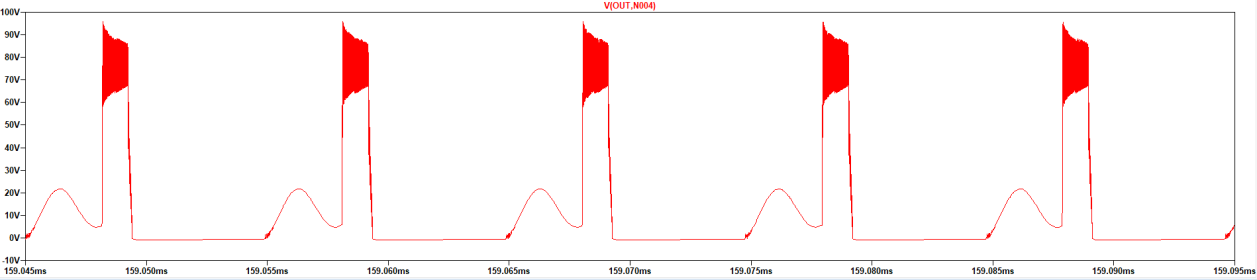
[picture p76: figure]

Figure 14: Diode voltage close view waveform

Selected diode breakdown voltage is 250 V and it can operate this voltage ratios. Diodes continuous current 40 A and as figure 9 shows secondary sides current reach 50 A initially but it is pulsative current and diode can operate pulsative current up to 80 A.

## Power Losses

### Transformer Power Losses

Required length of wire have been calculated for both primary and secondary in the transformer calculations part. Moreover, required number of strands also considered in both sides. A third winding is also necessary similar with the secondary side of the transformer for carrying reference voltage to the feedback pin of the transformer. As the primary and secondary windings’ resistances and rms currents have been calculated before, their copper losses can also be calculated.

Pcu = Ip

2Rp + Is

2Rs = 0.036 | [15]

In addition to the copper losses, there is also core losses exist due to fringing flux caused by the added gap in the ferrite core.

Bac =

0.4πNnpF (

Ip(pk)
2

) 10⁻⁴

lg +

MPL
μ

[T]

[16]

Bac: AC flux density

WK = 4.855 × 10⁻⁵
(f)

1.63(Bac)

2.62 [W/kg] | [17]

WK: Watts per kilogram

Pfe = (

mW g
) Wrfe × 10⁻³ = 5.3823 [W] | [18]

Pfe: Core loss

PΣ = Pcu + Pfe = 5.4183 [W] | [19]

PΣ: Total power loss

### Conduction Losses

According to the Equation [20] MOSFET conduction loss is 0.25W.

Pon,M = [Iout
2 +

ΔIL

2
12 ] Ron,M D
[20]

According to the Equation [21] diode conduction loss is 7.61W.

Pon,D = VfIout(1 − D) | [21]

### Switching Losses

According to the Equation [22] MOSFET conduction loss is 0.291.

Psw,M =

1
2

VinIout(trise + tfall)fsw

[22]

According to the Equation [23] MOSFET conduction loss is

Psw,D =

1
2

Vin Irr trr fsw

[23]

## PCB Design

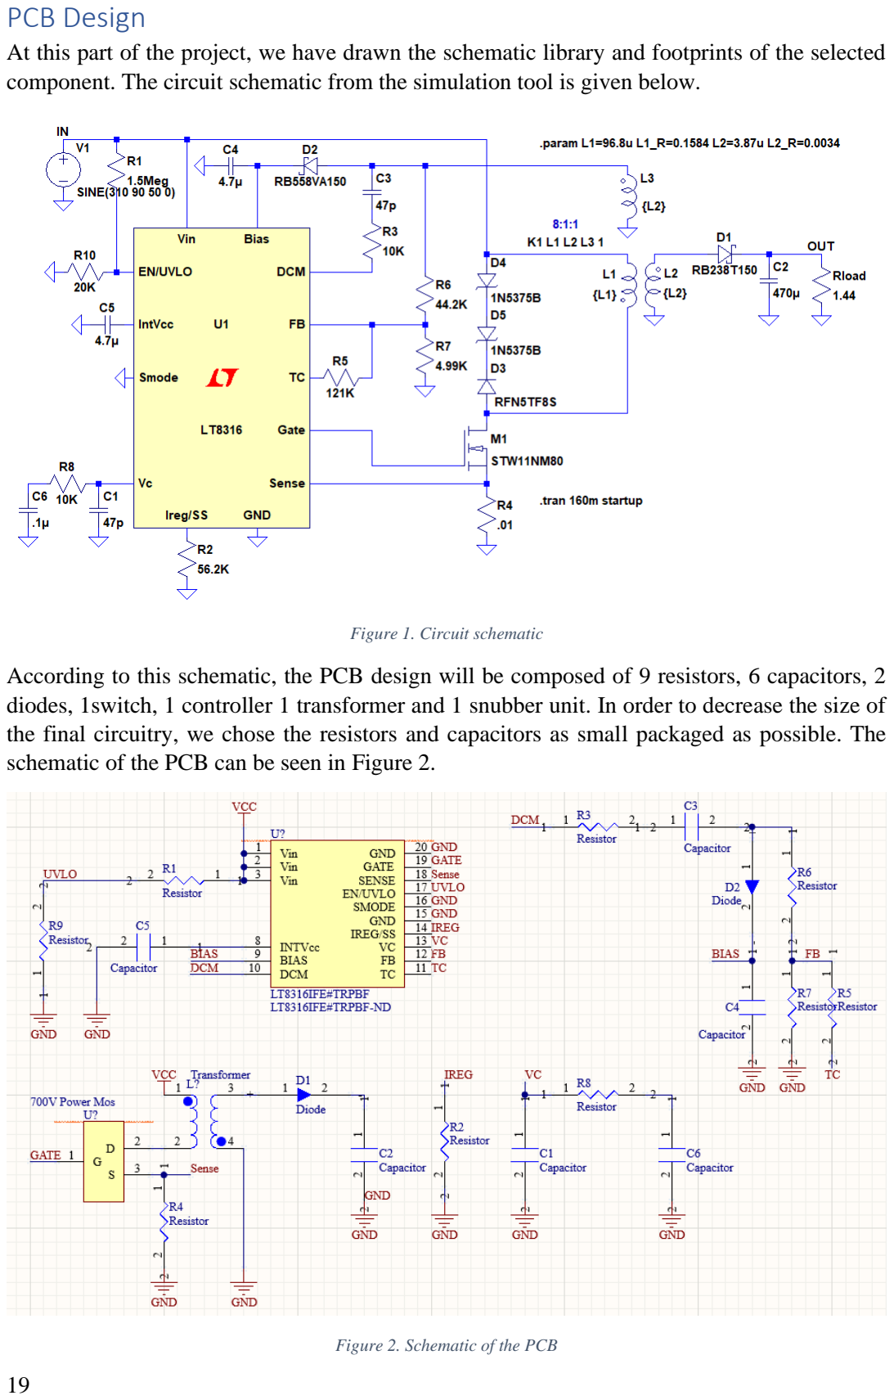
[picture p77: page 19]

At this part of the project, we have drawn the schematic library and footprints of the selected component. The circuit schematic from the simulation tool is given below.

Figure 1. Circuit schematic

According to this schematic, the PCB design will be composed of 9 resistors, 6 capacitors, 2 diodes, 1switch, 1 controller 1 transformer and 1 snubber unit. In order to decrease the size of the final circuitry, we chose the resistors and capacitors as small packaged as possible. The schematic of the PCB can be seen in Figure 2.

Figure 2. Schematic of the PCB

In this step, we placed all the component’ footprints and 3D models except the transformer, which will be final design made after the feedback session. However, we did not have chance to design the layout of the PCB since some of the calculations are still in progress about magnetic design. We have worked on an application not in order to design a fine PCB which does not create or effect any of the EMI signals and does not violate the isolation of the converter.

The first think that we will consider is the ground gridding. The ground layer has an important role in the PCB design since all the currents and signals that come to the circuit must leave the circuit and should not cause any interference. In order to decrease the noise on the circuit, we will design the ground as a polygon at the underneath of the controller and other components to supply a short current loop. Also, the bypass capacitors will be placed according to the Figure 3.

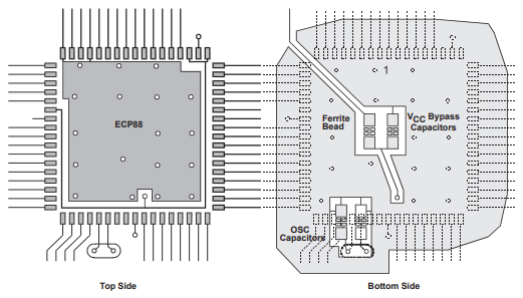
[picture p78: figure]

Figure 3. Controller Groung Example [1]

The other important thing is input and output power points. Since our design supplies around 8.5A current, the output power traces should be placed as they do not damaged due to rising temperature. For the trace size calculation Saturn PCB Toolkit will be used.

The other important thing is about getting feedback from the circuitry. To do this, we are using 100mΩ sense resistor. The replacement of this resistor is important since it is very low resistor, the point of the connection may cause change in the read voltage level. The traces should be placed as symmetrical.

In the PCB layout, the controller should be placed close to the power input. With this arrangement, the high-speed logic has less chance to pollute other signal traces. The transformer should be placed away from the controller in order to decrease the possible noises. Also, it should be considered the crosstalk problem while placing the traces, the space between the traces is important in order to decrease the capacitive and inductive crosstalk.

## Conclusion

Within the scope of this project, it is aimed to create a circuit that will perform the voltage conversion operation between the high voltage battery and low voltage battery in Tesla Model S vehicles. Thanks to this transformation, the devices in the low voltage range (12V) will be operated by using 220V – 400V input voltage. Since the system has high input voltage and low output voltage value, an isolated structure has been specifically studied. For this reason, isolated converter topologies were examined one by one and their advantages and disadvantages were evaluated. Later, studies were carried out on the transformer design to be used in isolated power transmission. After determining the required duty cycle and turns ratio values, the system was simulated and the rated values of the required components were determined. Lastly, theoretical calculations have been completed with component selection and power loss calculations.
