busranurkocak/EE464-Term-Project/Graphs/nonideal_graphs_withSnubber/Schmatic.PNG

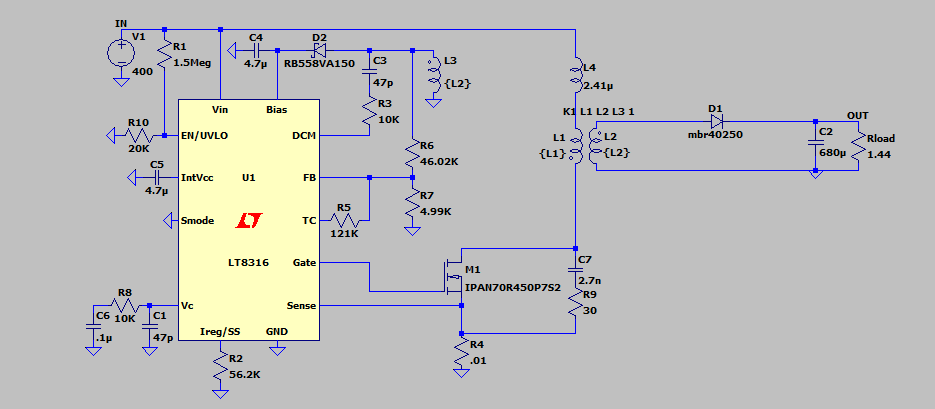
Graphs/nonideal_graphs_withSnubber/Schmatic.PNG
