busranurkocak/EE464-Term-Project/Graphs/nonideal_graphs_withSnubber/Vdiode.PNG

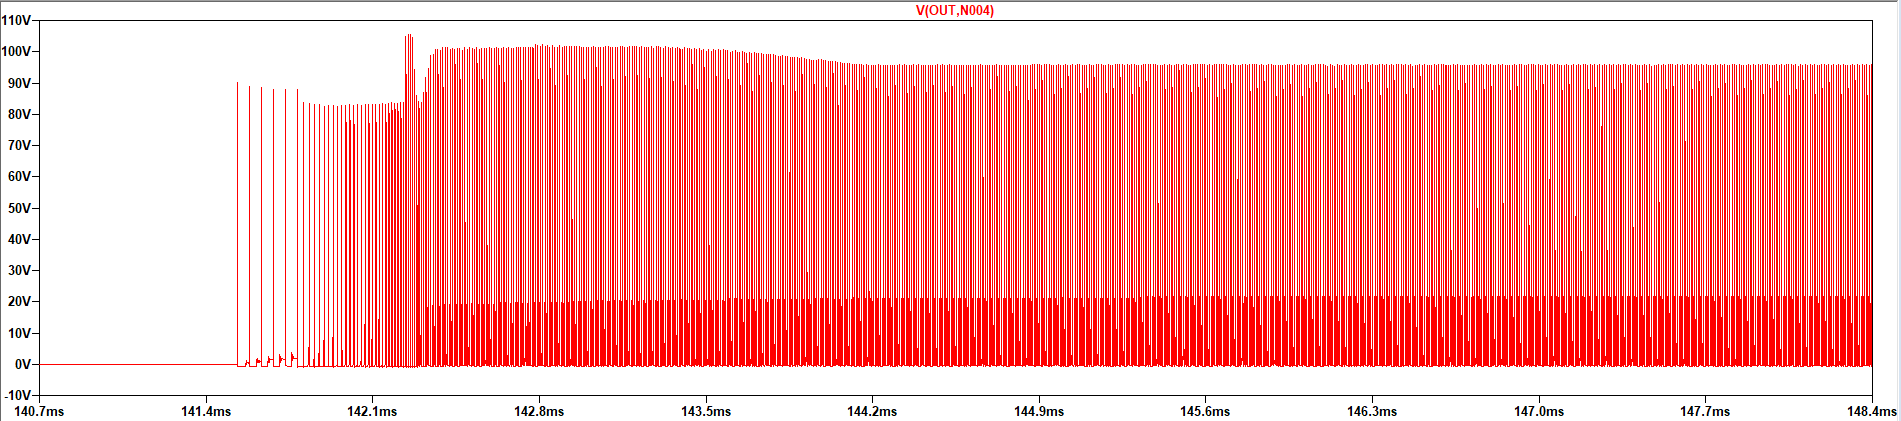
Graphs/nonideal_graphs_withSnubber/Vdiode.PNG
