busranurkocak/EE464-Term-Project/Graphs/nonideal_graphs_withSnubber/Vin.PNG

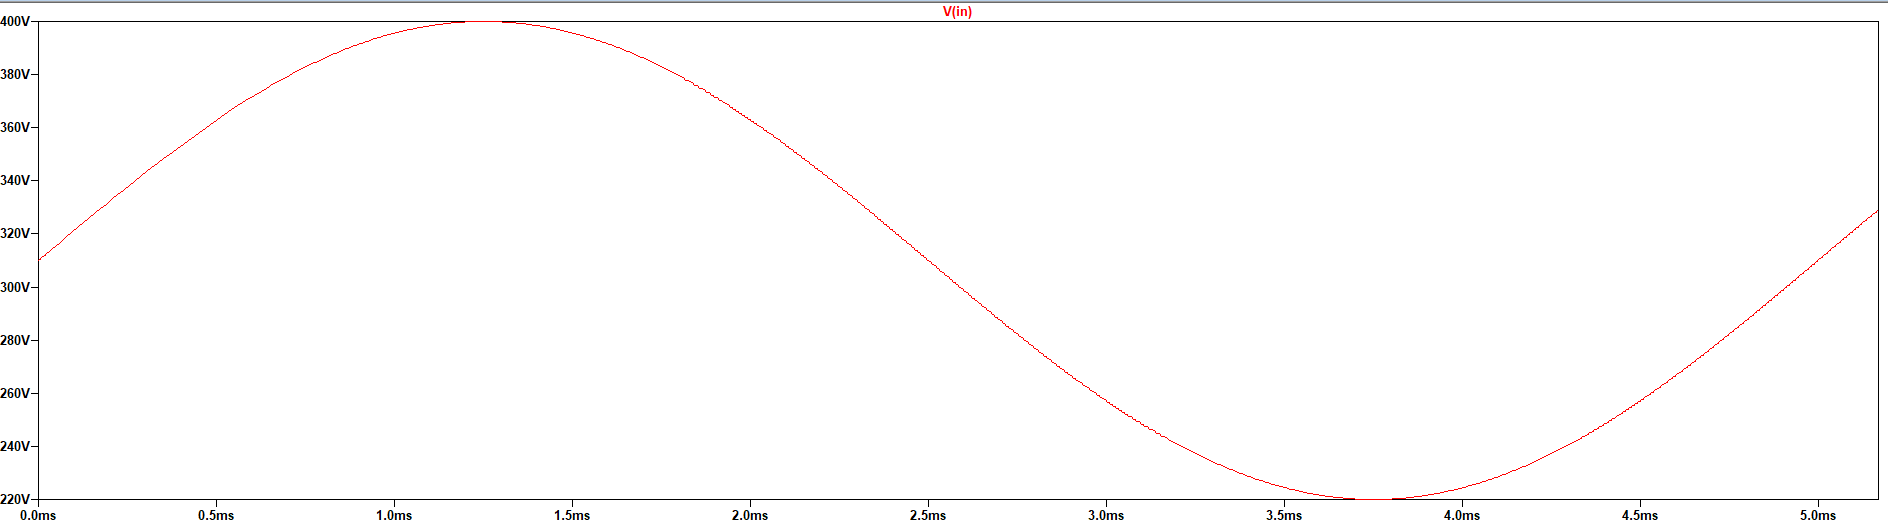
Graphs/nonideal_graphs_withSnubber/Vin.PNG
