busranurkocak/EE464-Term-Project/Graphs/nonideal_graphs_withSnubber/Vmosfet.PNG

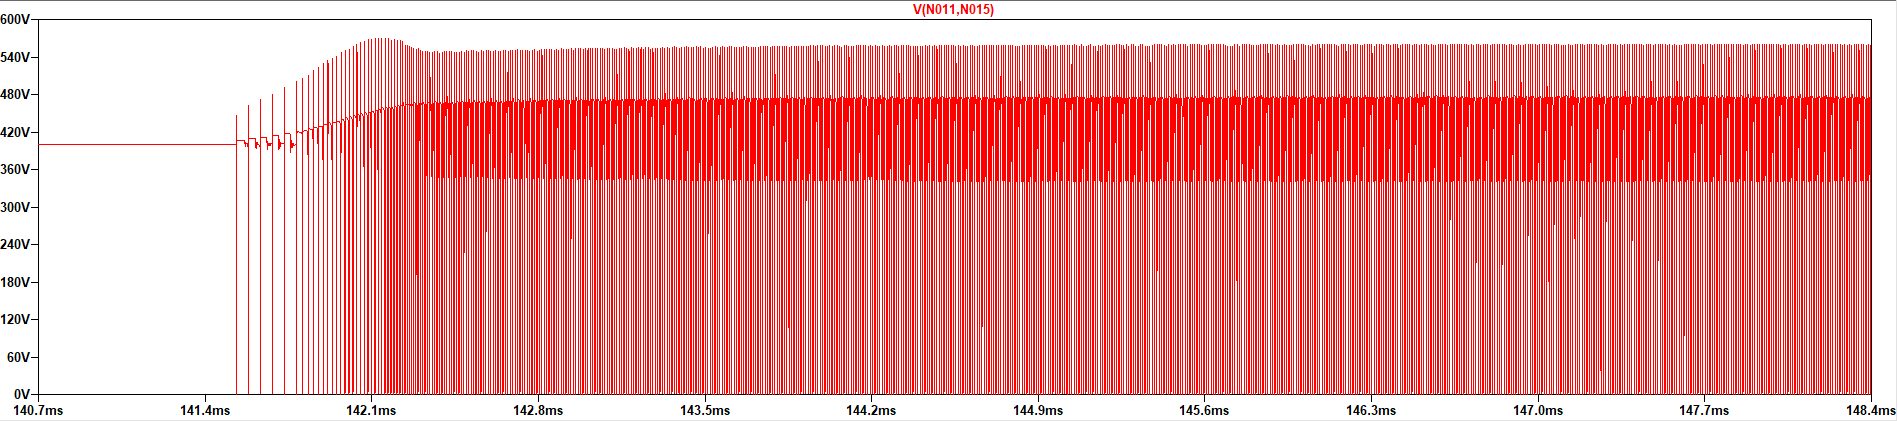
Graphs/nonideal_graphs_withSnubber/Vmosfet.PNG
