busranurkocak/EE464-Term-Project/Graphs/nonideal_graphs_withSnubber/Vpr_inductor.PNG

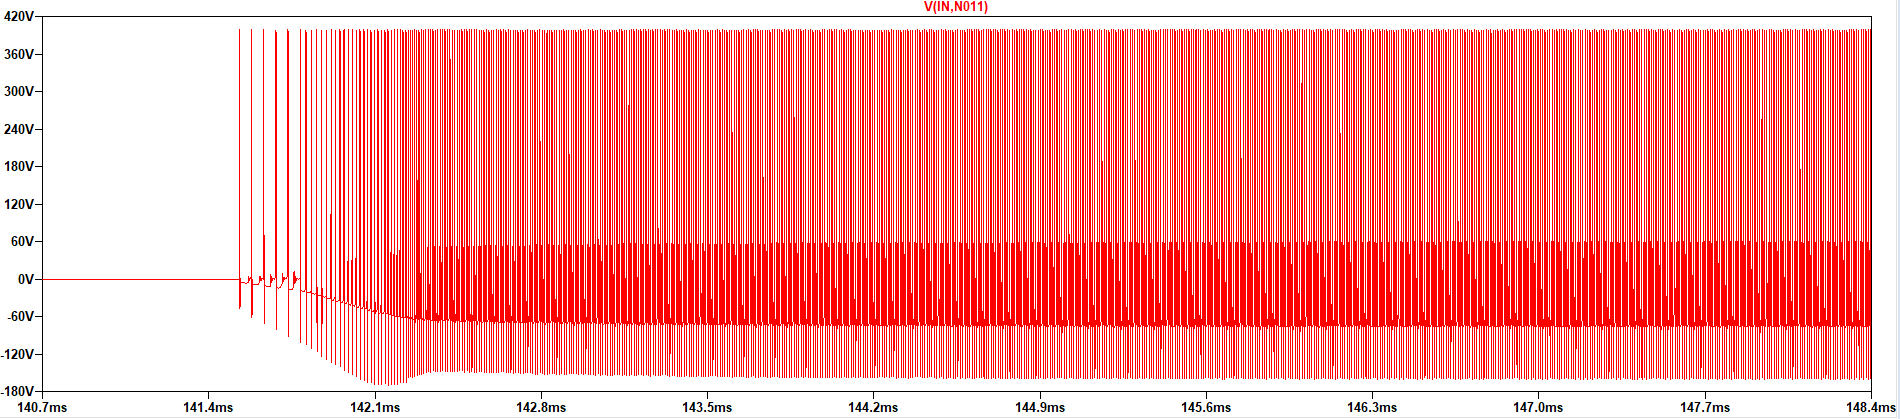
Graphs/nonideal_graphs_withSnubber/Vpr_inductor.PNG
