busranurkocak/EE464-Term-Project/COMPONENT.docx

COMPONENT | EXPLANATION | VOLTAGE | | CURRENT | | LINK
| | Required | Component | Required | Component
M1 | mosfet | >500
