busranurkocak/EE464-Term-Project/selected_components/components.docx

Mosfet

IPAN70R450P7S https://www.digikey.com/en/products/detail/infineon-technologies/IPAN70R450P7SXKSA1/8130840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

Secondary Diode

MBR40250G

https://www.digikey.com/en/products/detail/on-semiconductor/MBR40250G/1477183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

Output capacitance

RNL1C681MDS1

https://www.digikey.com/en/products/detail/nichicon/RNL1C681MDS1/9452660
