busranurkocak/EE464-Term-Project/Presentation/Final_presentation/Component_and_simulation_graphs.pptx

## Slide 2

EE464- TERM PROJECT

Büşra Nur Koçak
Defne Nur Korkmaz
Mustafa Mert Sarıkaya

July 13, 2021

## Slide 3

Topology Selection
Component Selection and Simulation Results
Losses and Thermal Results
PCB Design
Magnetic Design
Cost of the Design

## TOPOLOGY SELECTION

- FLYBACK CONVERTER


- Better utilization of transformer
- Easier to control
- DCM operation


## Operating Values

- DCM operation:
- Limits flux density
  - Smaller core
- Reduce switching losses
- Smooth start

- D_(max) =0. 35
- D_(dweel) =0.1
- f_s ≅100 kHz

## Magnetic Design

- Iron Powder Core Selection

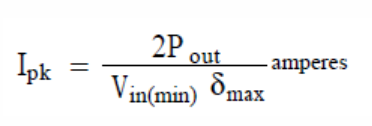
[picture p85: figure]

L_(pri) I_(pk)^2 =2 mH∗(2.6A)^2 =2 mH∗A^2

## Slide 7

Iron Powder Core Selection


Kool Mµ E Core energy storage table

## Slide 8

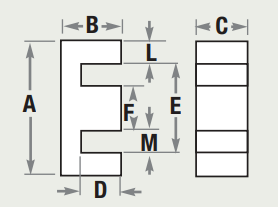
[picture p86: figure]
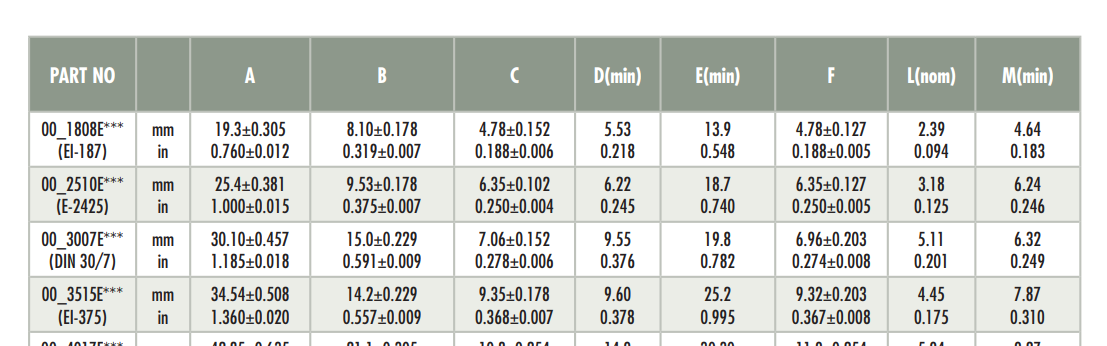
[picture p87: figure]

## Selecting Turns and Wire Size

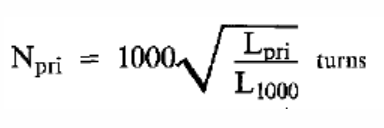
[picture p88: figure]
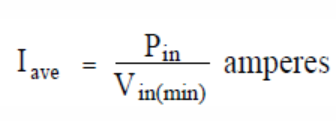
[picture p89: figure]

δ=√(ρ/(π∗f∗μ))≅0.209×10^(−3) m

## Selecting Turns and Wire Size

Property | Value
L | 92 nH
Npri | 57 turns
Nsec | 7 turns
Turns Ratio | 8
Cable | 26 AWG
Primary Parallel Cable | 2
Secondary Parallel Cable | 12
Kcu | 0.31

## Component Selection and Simulations

## Controller


Parameter | Value - Description
Vin | 16V – 600V
FSW(Min) | 3 kHz
FSW(Max) | 140 kHz
Operating Junction Temperature | -40 – 125oC
Price | $2.18 (1000+ order)

## Mosfet (IPAN70R450P7S)


Parameter | Value - Description
VDS , Breakdown voltage | 700V
ID, Continuous current | 10A at TC =20 oC
ID,pulse Pulsed Drain current | 25.9 A
RDS,ON | 450mΩ
Qg | 13.1nC
Price | $1.05

## Mosfet Voltage Waveform

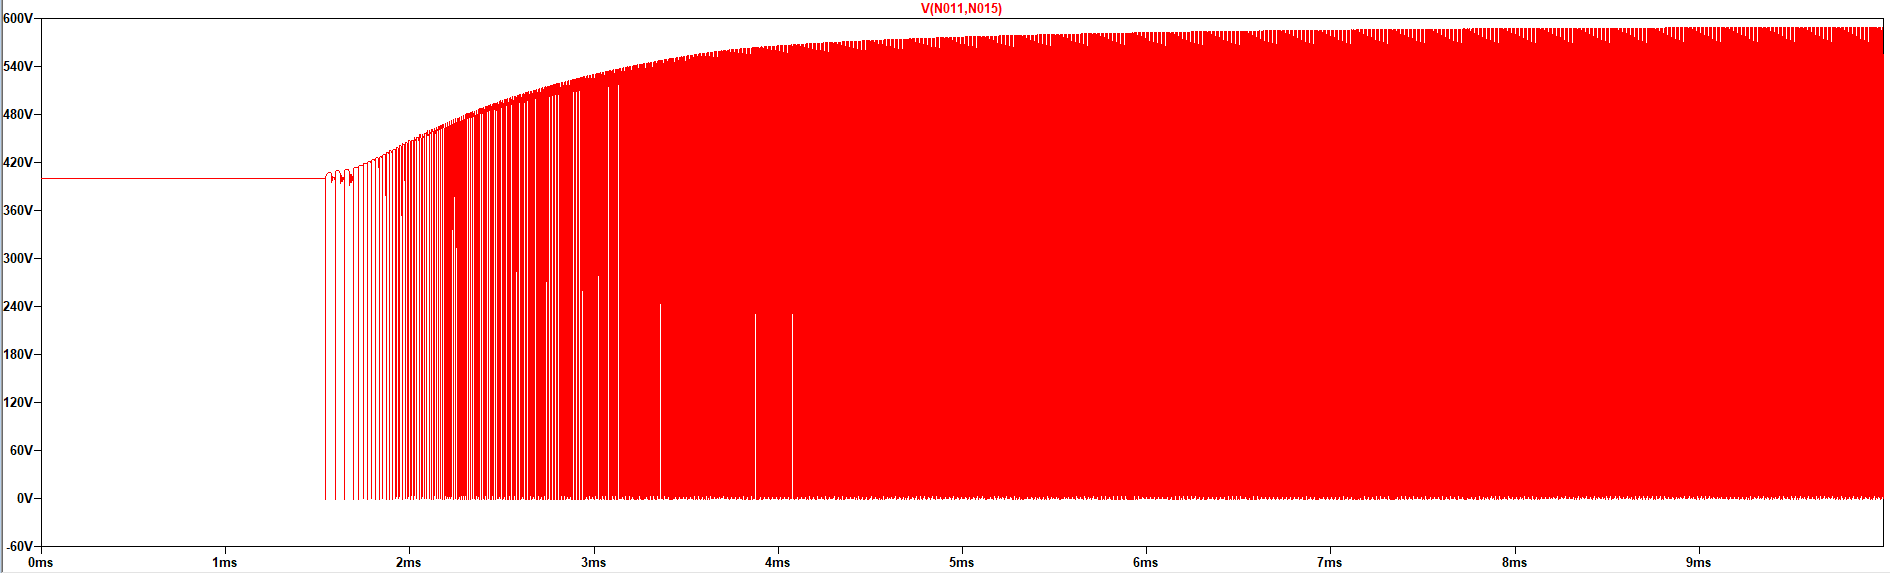
[picture p90: figure]

## Mosfet Current Waveform

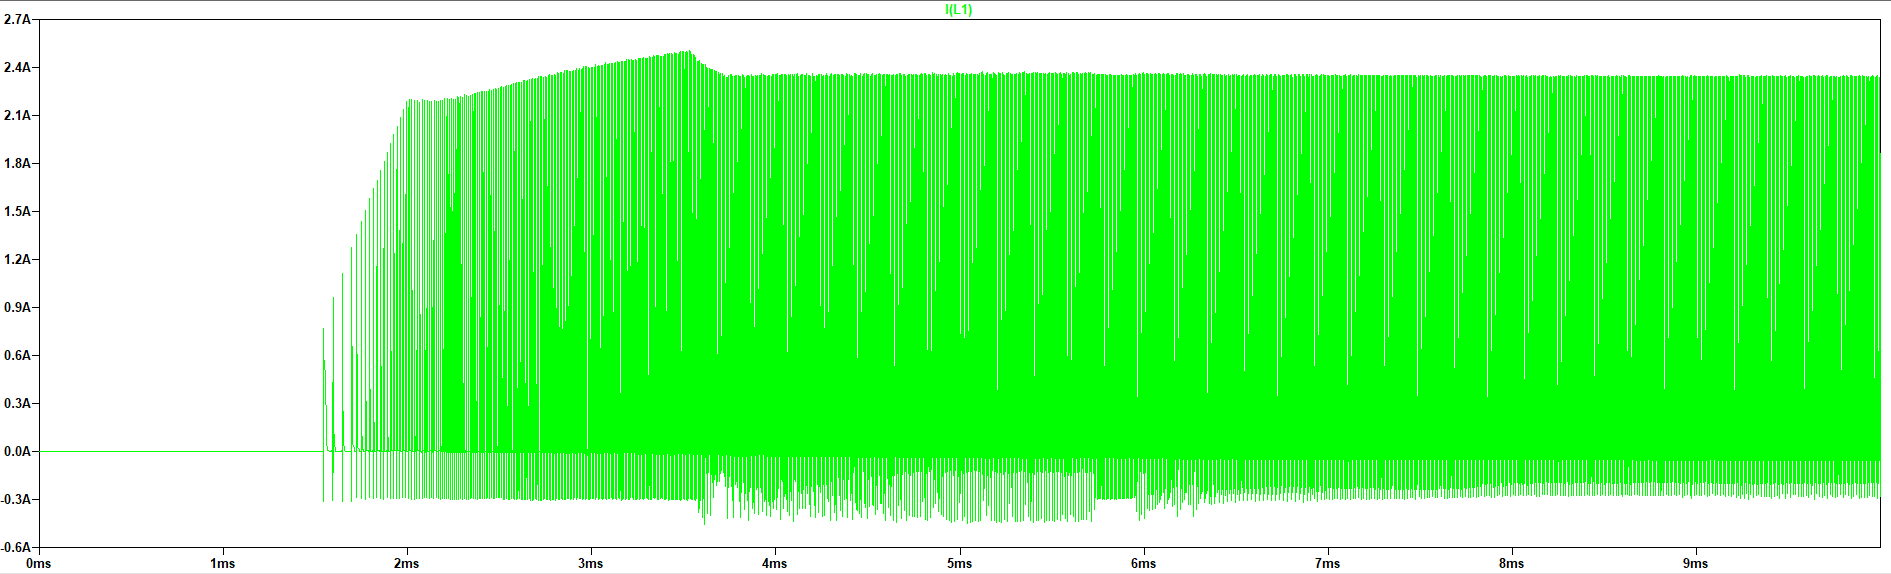
[picture p91: figure]

## Diode(MBR40250G)


Parameter | Value - Description
VR , Blocking voltage | 250V
IRMS, Continuous current | 40A
IFRM, Peak Repetitive Forward Current | 80A
VF | 0.86V
Price | $1.82000

## Diode Voltage Waveform

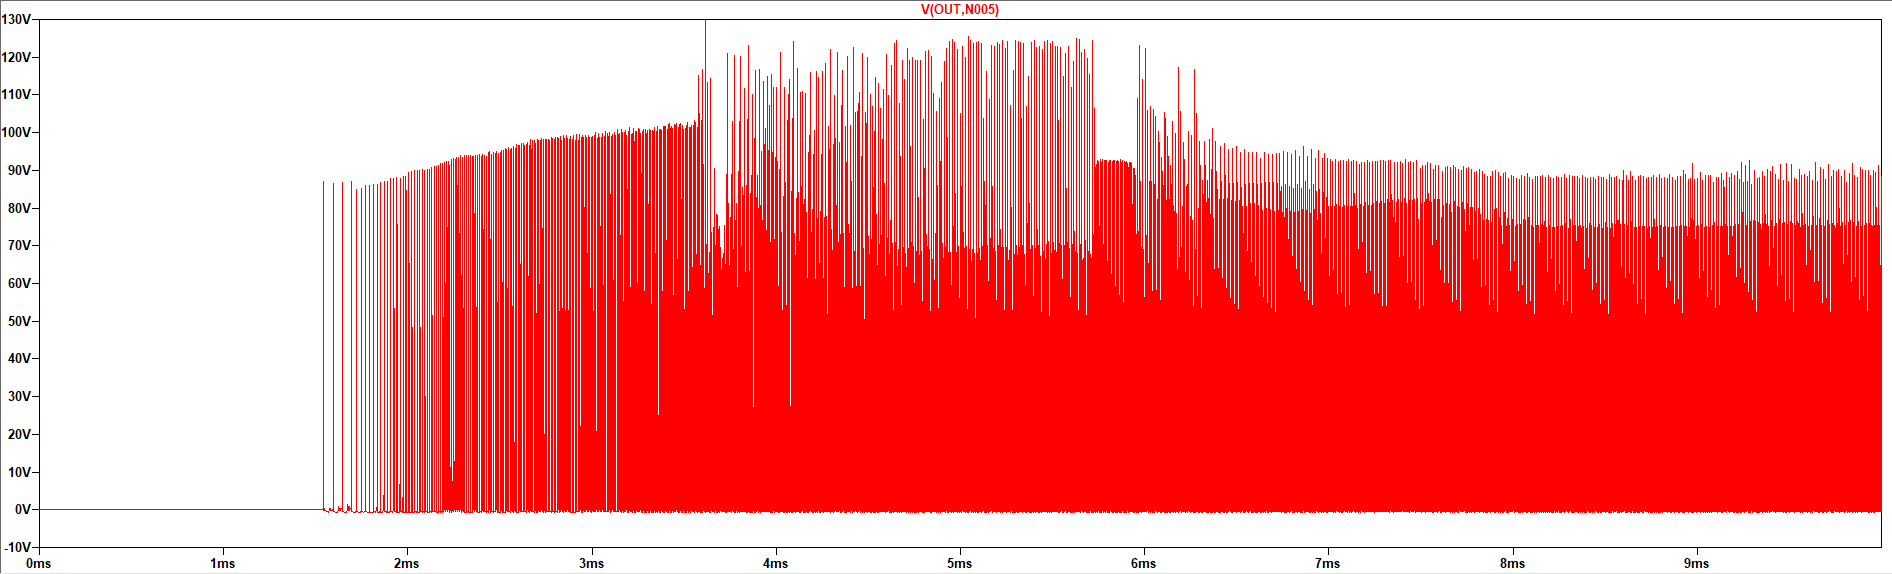
[picture p92: figure]

## Diode Current Waveform

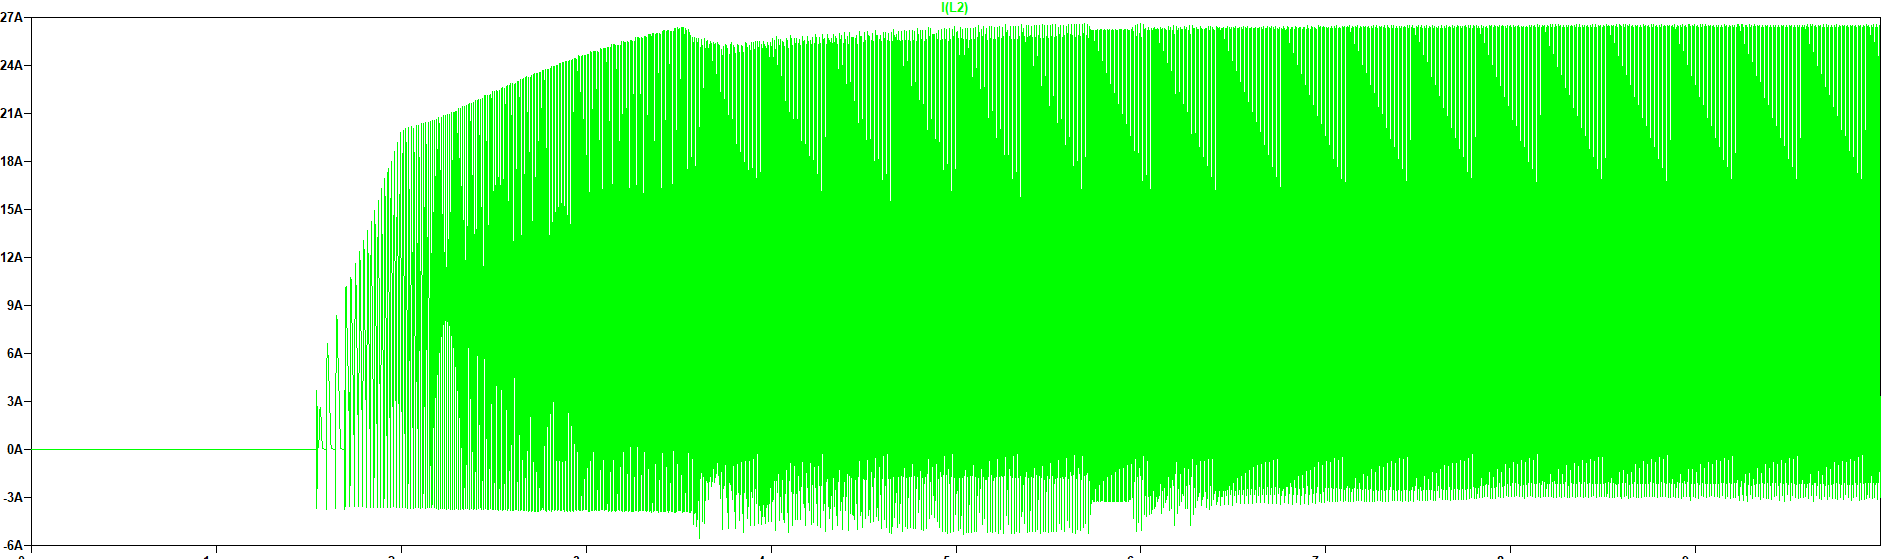
[picture p93: figure]

## Output Capacitor(337ULR016MFF)

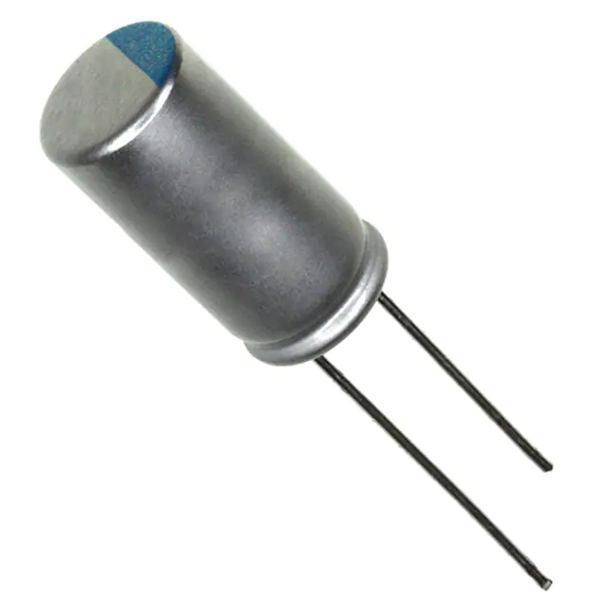
[picture p94: figure]

Parameter | Value - Description
C, Capacitance | 330 uF
VC,MAX Rating | 16V
IC,ripple | 4.3A
ESR | 13mΩ
Price | 0.2925$ x2

## Output Voltage Waveform


## Output Current Waveform


## Efficiency = 88.98 %

Losses

Type | Value
Mosfet Switching Loss | 0.8285 W
Mosfet Conduction Loss | 0.0157 W
Mosfet Total Loss | 0.8442 W
Diode Switching Loss | 0.0032 W
Diode Conduction Loss | 7.167 W
Diode Total Loss | 7.1702 W
Snubber Loss | 4 W
Transformer Core Loss | 0.124 W
Transformer Copper Losses | 0.2431 W
Transformer Total Loss | 0.3671 W
Total Loss | 12.3815 W

## Thermal Results

Component | Temperature
Mosfet | 92.5 oC
Diode (without Heatsink) | 338.5 oC
Diode (with Heatsink) | 121.1 oC
Transformer | 234 oC

## Heatsink(HSE-B20380-040H-01 )

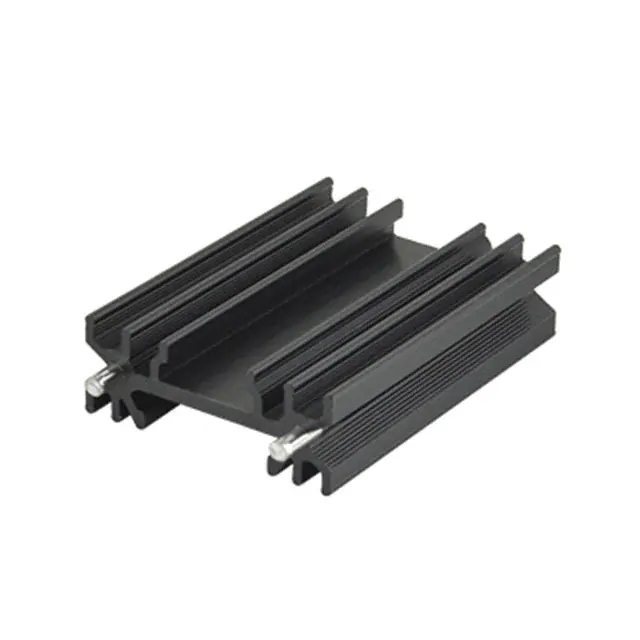
[picture p95: figure]
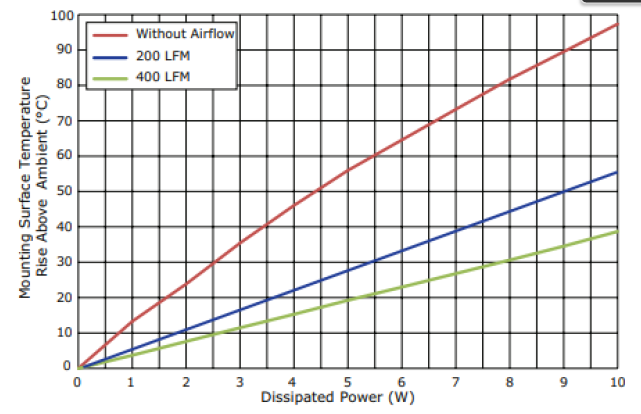
[picture p96: figure]

## PCB Design


Overall PCB Design

## Slide 26


Top view of the PCB

## Slide 27


Dimensions:
3.7 x 6.2 x 4 = 91.76 cm^3
With the heat sink:
4.5 x 6.2 x 4 = 111.6 cm^3

## Cost Analysis

Component | Price ($)
K3007E90 core | 0.78
B66232J1112T001 Bobbin | 0.82
Copper Cable (11 m) | 2.25
IPAN70R450P7S | 0.69
MBR40250G | 1.0178
337ULR016MFF (x2) | 0.2925 x 2
Resistors (1.5Mohm – 10Kohm) (x8) | 0.005 x 8
354010KFT Resistor | 0.468
ERJ-3BWFR033V Resistor | 0.0074
ERJ-2LWJR010X Resistor | 0.045
UVK105CG4R7JW-F Capacitor (x2) | 0.05 x 2
04026D105KAT4A Capacitor | 0.027
885012005078 Capacitor | 0.029
TMK105BJ104MV-F Capacitor | 0.006
BAS3010A03WE6327HTSA1 Diode | 0.125
S5KCTR Diode | 0.0966
HSE-B20380-040H-01 Heat Sink | 0.529
PCB | 0.679
Total | 8.298
