busranurkocak/EE464-Term-Project/Graphs/Graphs_for_components/Idiode.PNG

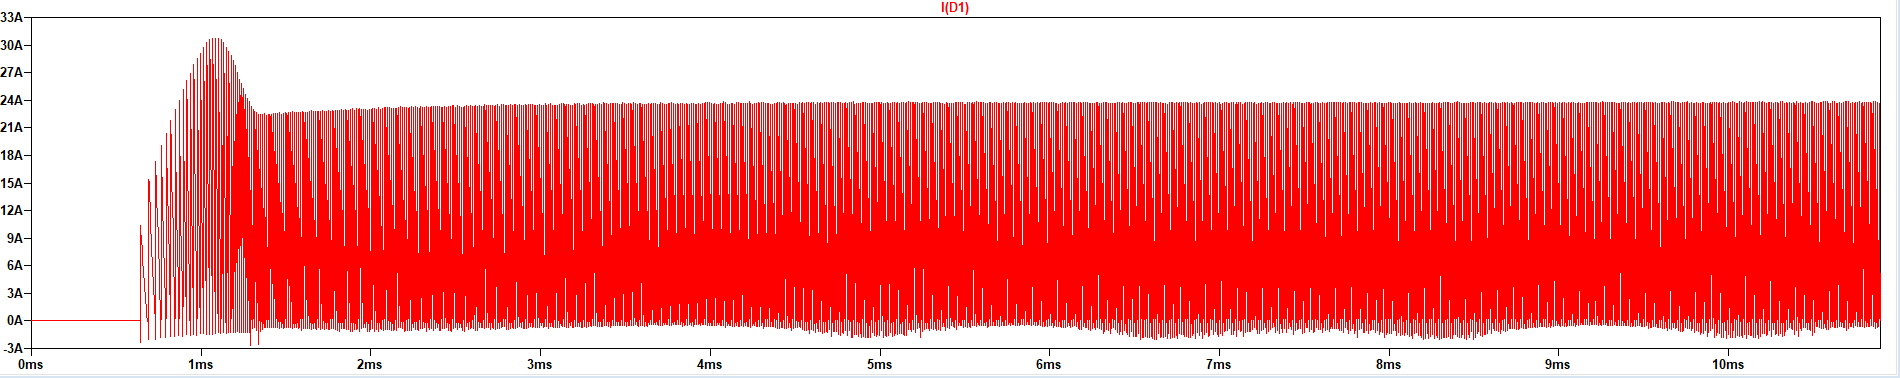
Graphs/Graphs_for_components/Idiode.PNG
