busranurkocak/EE464-Term-Project/Graphs/Graphs_for_components/Imosfet.PNG

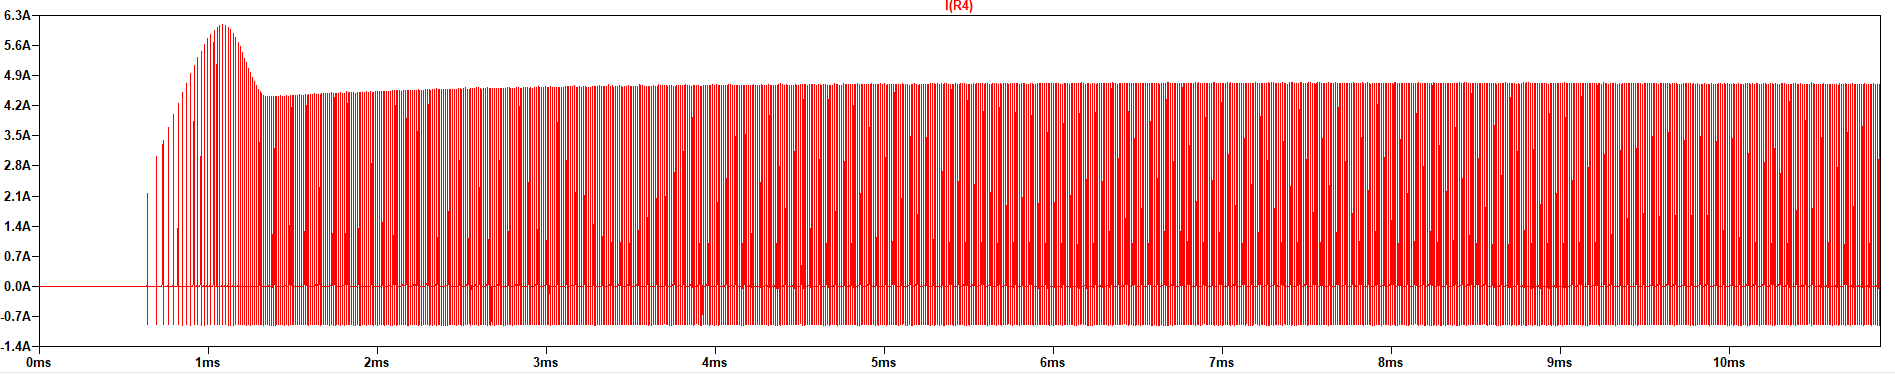
Graphs/Graphs_for_components/Imosfet.PNG
