busranurkocak/EE464-Term-Project/Graphs/Graphs_for_components/Iout.PNG

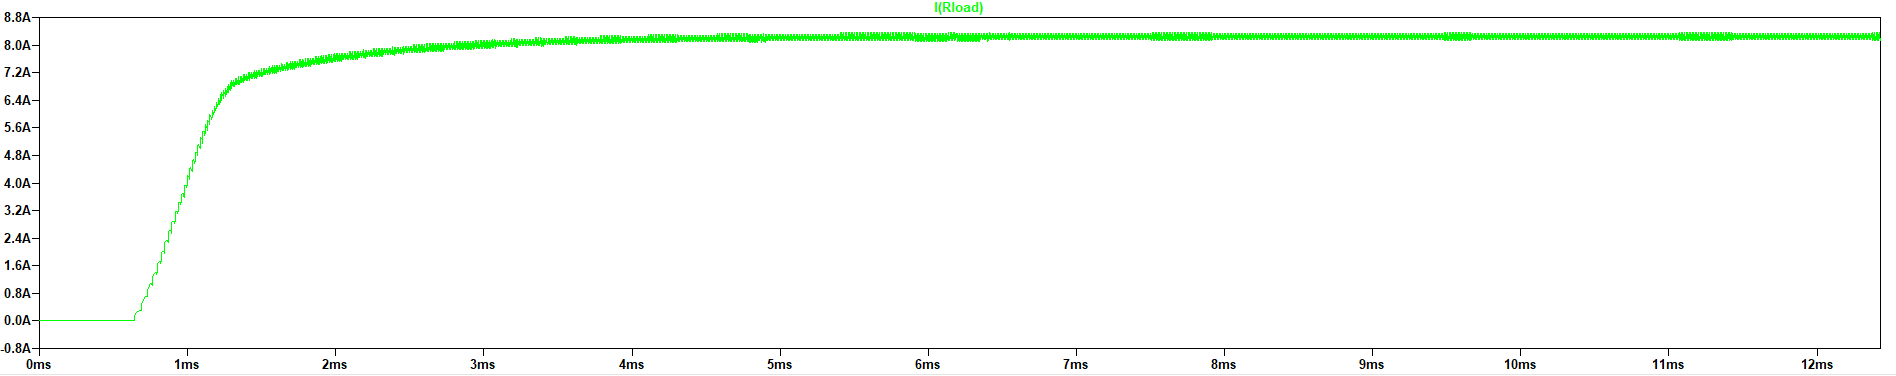
Graphs/Graphs_for_components/Iout.PNG
