busranurkocak/EE464-Term-Project/Graphs/Graphs_for_components/V_I_diode.PNG

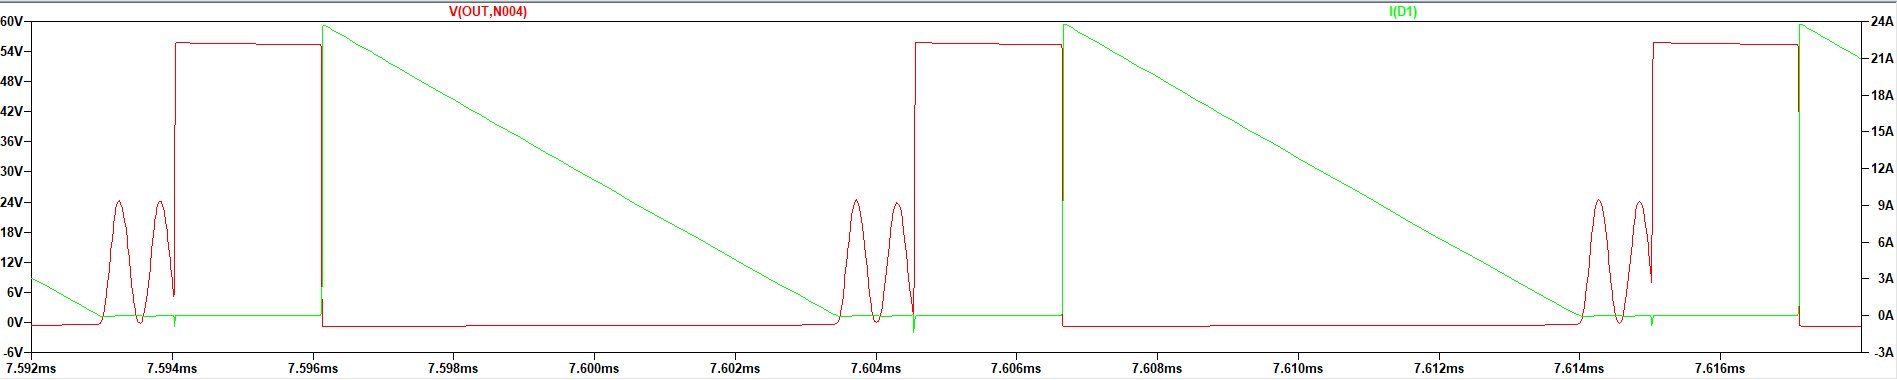
Graphs/Graphs_for_components/V_I_diode.PNG
