busranurkocak/EE464-Term-Project/Graphs/Graphs_for_components/V_I_mosfet.PNG

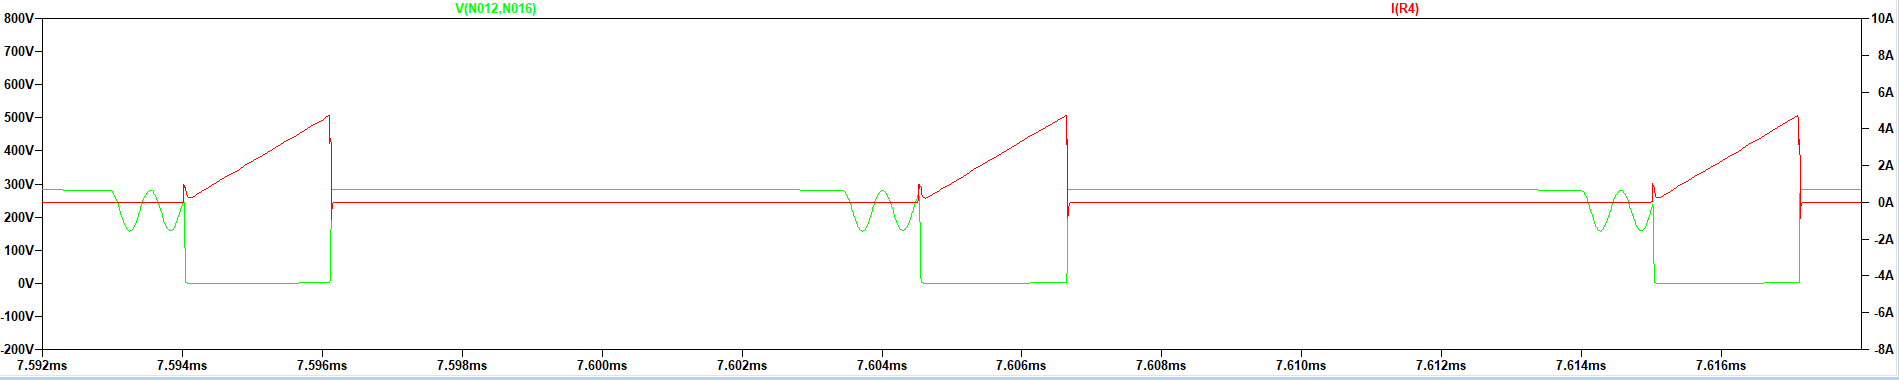
Graphs/Graphs_for_components/V_I_mosfet.PNG
