busranurkocak/EE464-Term-Project/Graphs/Graphs_for_components/Vdiode.PNG

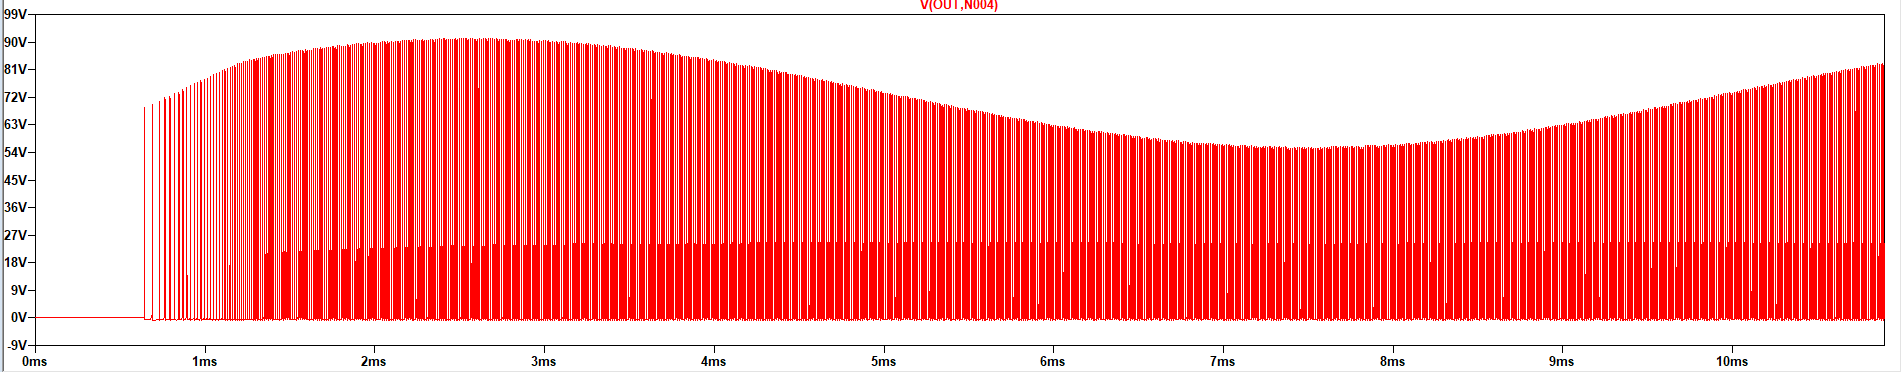
Graphs/Graphs_for_components/Vdiode.PNG
