busranurkocak/EE464-Term-Project/Graphs/Graphs_for_components/Vout.PNG

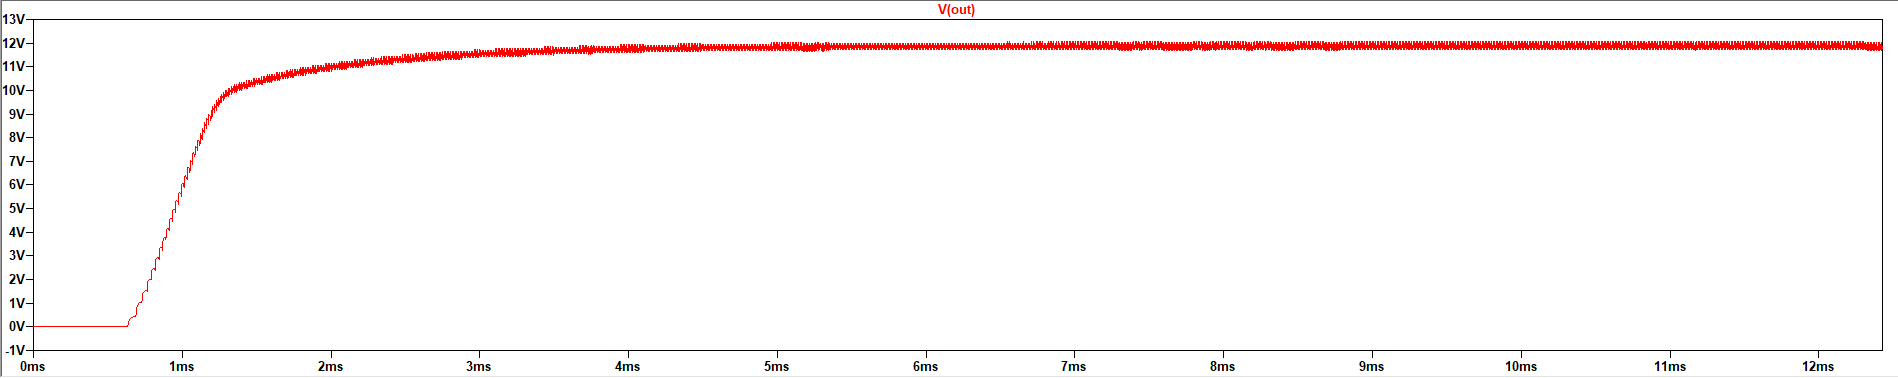
Graphs/Graphs_for_components/Vout.PNG
