busranurkocak/EE464-Term-Project/464HardwareProject/PCB drawing/0402C.STEP

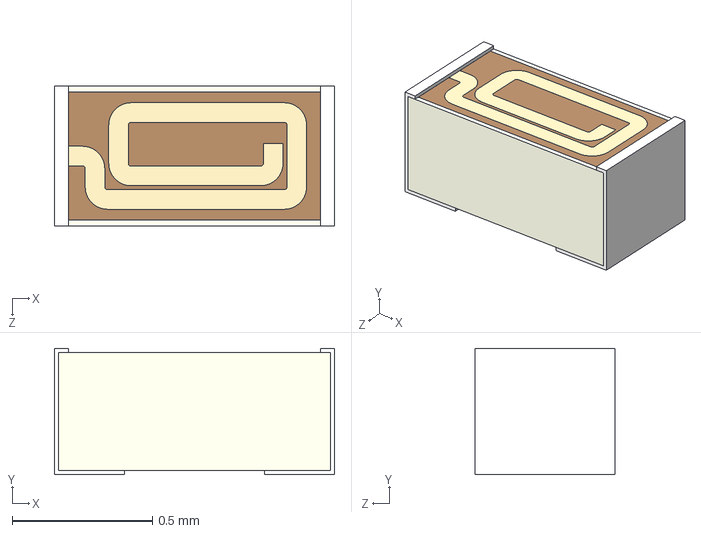
[picture p104: CAD file, 2021-04-27]
464HardwareProject/PCB drawing/0402C.STEP
1.00 x 0.45 x 0.5 mm
