busranurkocak/EE464-Term-Project/464HardwareProject/PCB drawing/LT8316EFE#PBF.STEP

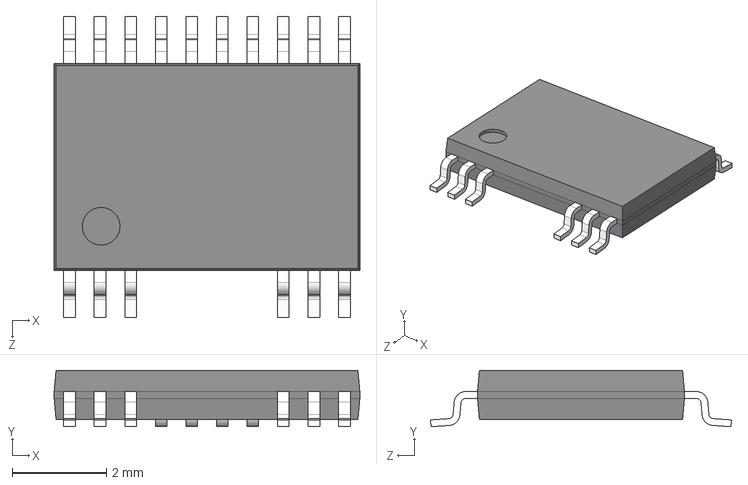
[picture p105: CAD file, 2021-04-27]
464HardwareProject/PCB drawing/LT8316EFE#PBF.STEP
6.50 x 1.20 x 6.40 mm
