busranurkocak/EE464-Term-Project/Simulations/Flyback_converter_LTspice_v6.asc

C1: cap; 4.7µ
C2: cap; 680µ; Rser=8m
C3: cap; 47p
C4: cap; 4.7µ
C6: cap; 100n
C7: cap; 1µ
C8: cap; 4.7p
D1: diode; mbr40250
D2: schottky; RB558VA150
D3: diode
L1: ind2; {L1}; Rser={L1_R}
L2: ind2; {L2}; Rser={L2_R} Cpar=0.5p
L3: ind2; {L2}; Rser=0.12
L4: ind; 2.965µ
R1: res; 1.5Meg
R2: res; 56.2K
R3: res; 10K
R4: res; 32m
R5: res; 121K
R6: res; 46.02K
R7: res; 4.99K
R8: res; 10k
R9: res; 10k
R10: res; 20K
R11: res; 10m
Rload: res; 1.44
U1: LT8316
U2: IPAN70R450P7S_L0
V1: voltage; 400
Named nets: 0, IN, OUT
K1 L1 L2 L3 1
.tran 0 150m 140m startup
.param L1=296.5u  L1_R=0.2060 L2=2.234u L2_R=0.004m
.model mbr40250 d
+IS=3e-06 RS=0.00398945 N=1.75864 EG=0.999094
+XTI=5 BV=250 IBV=0.00025 CJO=9.00035e-10
+VJ=0.557029 M=0.428275 FC=0.5 TT=3.47959e-08
+KF=0 AF=1
.inc Simulation_model_CoolMOS_P7_MOSFET_700V_Spice.lib
