busranurkocak/EE464-Term-Project/Simulations/Flyback_low_duty.asc

C1: cap; 47p
C2: cap; 470µ; Rser=15m
C3: cap; 47p
C4: cap; 4.7µ
C5: cap; 4.7µ
C6: cap; .1µ
D1: schottky; RB238T150
D2: schottky; RB558VA150
D3: diode; RFN5TF8S
D4: zener; 1N5375B
D5: zener; 1N5375B
L1: ind2; {L1}; Rser={L1_R}
L2: ind2; {L2}; Rser={L2_R} Cpar=0.5p
L3: ind2; {L2}; Rser=0.12
M1: nmos; STW11NM80
R1: res; 1.5Meg
R2: res; 56.2K
R3: res; 10K
R4: res; .01
R5: res; 121K
R6: res; 44.2K
R7: res; 4.99K
R8: res; 10K
R10: res; 20K
Rload: res; 1.44
U1: LT8316
V1: voltage; SINE(310 90 50 0)
Named nets: 0, IN, OUT
K1 L1 L2 L3 1
.tran 160m startup
8:1:1
.param L1=96.8u L1_R=0.1584 L2=3.87u L2_R=0.0034
