busranurkocak/EE464-Term-Project/(list of files, drawings)

Other design files:
464HardwareProject/464HardwareProject.PcbDoc
464HardwareProject/464HardwareProject.PcbLib
464HardwareProject/464HardwareProject.PrjPcb
464HardwareProject/464HardwareProject.SchDoc
464HardwareProject/464HardwareProject.SchLib
464HardwareProject/PCB drawing/SOP65P640X120-21N.PcbLib
