busranurkocak/EE464-Term-Project/(commit log)

2021-04-25 Magnetic calculation file for the flyback converter design.
2021-04-26 combined with magnetic
2021-04-26 some corrections applied
    diode power loss included to output power ratio at step 3-4-5
    D_w variables math operator changed in step 28 and 30
    N_turn_ratio calculating now based on N_np and N_s
2021-04-27 PCB design is started to progress.
    [464HardwareProject.PcbDoc, 464HardwareProject.PcbLib, 464HardwareProject.PrjPcb, 464HardwareProject.SchDoc, 464HardwareProject.SchLib, GRM155R71E752KA01D.STEP, LT8316EFE#PBF.STEP, SOP65P640X120-21N.PcbLib]
2021-04-28 LT8316 feedback resistanca values have been added to the calculations.
2021-04-30 Magnetic calculations have been updated.
2021-05-02 PCB design.
    [0402C.STEP, 0402R.STEP, 464HardwareProject.PcbDoc, 464HardwareProject.PcbLib, 464HardwareProject.PrjPcb, 464HardwareProject.SchDoc, 464HardwareProject.SchLib]
2021-05-02 Component selection and PCB design
2021-05-02 Power loss calculations for the transformer added.
2021-05-02 Component power calculations added
2021-05-02 Power loss equations added
2021-06-29 Total loss and temperature rise calculations have been added.
2021-07-02 PCB libraries are updated.
    [464HardwareProject.PcbDoc, 464HardwareProject.PcbLib, 464HardwareProject.PrjPcb, 464HardwareProject.SchDoc, 464HardwareProject.SchLib]
2021-07-03 Selecting turns and wire size part about the transformer has been added to the final report.
2021-07-03 PCB design
    [464HardwareProject.PcbDoc, 464HardwareProject.PcbLib, 464HardwareProject.PrjPcb, 464HardwareProject.SchDoc, 464HardwareProject.SchLib]
2021-07-03 PCB design part of the final report.
2021-07-13 PCB design has been added to the presentation.
2021-07-13 Magnetics' iron powder core catalog has been added.
